42engineer42/Autonomous_drone_juuksur/Software/juuksur2.1/juuksur/README.md

# Juuksur

Robot, mis on mõeldud Robotex'il droonide takistus lennus võistlemiseks
