42engineer42/Autonomous_drone_juuksur/Electronics/REV3/Droon_REV3.xlsx

Sheet: Droon_REV3
Comment | Description | Designator | Footprint | LibRef | Quantity Required | Farnell product code | Quantity already available | Order Quantity
65R | Resistor | R1, R4, R8, R12, R15 | R 0603 | Res | 5 | 2331324 | 4 | 1 | -1
150R | Resistor | R17 | R 0603 | Res | 1 | 2447255 | 8 | 0 | 7 | -1
10R | Resistor | R2, R3, R5, R6, R10, R11, R13, R14 | R 0603 | Res | 8 | 2861437 | 0 | 10 | -8 | 2
1k | Resistor | R7 | R 0603 | Res | 1 | 1469740 | 0 | 10 | -1 | 9
2k | Resistor | R9 | R 0603 | Res | 1 | 1469764 | 0 | 10 | -1 | 9
13pF | Capacitor Ceramic | C5, C6 | C0603 | Capacitor | 2 | 1865473 | 18 | 0 | 16 | -2
0.1uF | Capacitor Ceramic | C1 | C0603 | Capacitor | 1 | 2429362 | 0 | 5 | -1 | 4
2.2uF | Capacitor Ceramic | C2 | C0603 | Capacitor | 1 | 3013394 | 0 | 5 | -1 | 4
10nF | Capacitor Ceramic | C3 | C0603 | Capacitor | 1 | 9406182 | 0 | 5 | -1 | 4
0.47uF | Capacitor Ceramic | C4 | C0603 | Capacitor | 1 | 1759405 | 0 | 5 | -1 | 4
10uF | Capacitor Ceramic | C8 | C0603 | Capacitor | 1 | 2494230 | 15 | 0 | 14
4.7uF | Capacitor Ceramic | C7 | C0603 | Capacitor | 1 | 3013398 | 16 | 0 | 15 | -1
OVS-3309 | LED RGB | D1, D2, D3, D4 | LED RGB | LED Tripple | 4 | 2917849 | 10 | 0 | 6 | -4
Header 6p | Header 6p | J2, J7, J8 | JST-SH 6pin 1mm pitch | Header 6p | 3 | 1679131 | 0 | 10 | -3 | 7
2x1 Header | 2x1 Header | J9, J10 | Header 1x2 2.54mm | 2x1 Header (power) | 2 | OK | OK | 0 | Piisavalt
150uH | Inductor | L2, L3 | Inductor 12.5x12.5x6mm | Inductor | 2 | 1852853 | 3 | 0 | 1
2V 20mA Green LED | LED | D5, D7 | LED 0603 | LED Single | 2 | 1465991 | 10 | 0 | 8
SS34 | Diode Schottky | D6 | Schottky Rectifier diode | Diode Schottky | 1 | 2101196 | 5 | 0 | 4
100uF | Capacitor | C9 | Capacitor Through Hole 5x11 | Capacitor Polarized | 1 | 2811468 | 0 | 3
470uF | Capacitor | C10 | Through hole Capacitor 16V 470uF | Capacitor Polarized | 1 | 9693602 | 0 | 3
16MHz | Quarz crystal | Q1 | Clock 2012"(5032) | Crystal | 1 | 1841946 | 5 | 0 | 4
Bluetooth HC-05 | Header 6p 2.54mm | J6 | HEADER 6x1 2.54 | Header 6p | 1 | OK | OK | 0 | Piisavalt
Inductor 1uH | Inductor | L1 | C1206 | Inductor | 1 | 2470288 | 6 | 0 | 5
LM2576-5.0WU | IC REG BUCK 5V 3A TO263-5 | U3 | 5V 3A REG | LM2576-5.0WU | 1 | 3008144 | 3 | 0 | 2
Power Switch 1A | Power Switch | J11 | POWER SWITCH | Power Switch | 1 | 2854845 | 3 | 0 | 2
Header 4p | Header 4p | J1, J3, J4 | JST-SH 4pin 1mm pitch | Header 4p | 3 | 1830839 | 4 | 0 | 1
RPi_PWR+UART | Header 2x20 2.54mm | J5 | Header 2x20 2.54mm | RPi_PWR+UART | 1 | 2847248 | 0 | 2 | 1
IMU | IMU | S1 | IMU-ICM-20689 | IMU_ICM-20689 | 1 | 2911512 | 0 | 2 | 1
STM32F303RDT6 | ARM Cortex-M4 32-bit MCU, 384 KB Flash, 80 KB Internal RAM, 51 I/Os, 64-Pin LQFP, -40 to 85 degC, Tray | U1 | LQFP64-STM32F303 | LQFP64-STM32F303 | 1 | 2488300 | 2 | 0 | 1
TSOT-5 3V3 REG | ANALOG DEVICES ADP2108AUJZ-3.3-R7 STEP-DOWN DC/DC CONVERTER, TSOT-5 | U2 | SOT-5 3V3 REG | TSOT-5 3V3 REG | 1 | 2112606 | 0 | 5
RPI3-MODAP - Single Board Computer, Raspberry Pi 3 Model A+, BCM2837B0 SoC, Dual-Band WiFi, IoT | Raspberry Pi 3 A+ | None | None | None | 1 | 2946269 | 0 | 2 | 1
HT-225D - Crimp Tool, Ratchet, 30-18AWG D-Sub Contacts | Crimp tool | None | None | None | 1 | 1624832 | 0 | 1 | 0
SSH-003T-P0.2 - Contact, SH Series, Socket, Crimp, 28 AWG, Tin Plated Contacts, JST SH Series Housings | JST-SH 1mm crimp | None | None | None | 20 | 1679142 | 0 | 100 | 80
SHR-06V-S-B - Connector Housing, SH Series, Receptacle, 6 Ways, 1 mm, SSH-003T-P0.2-H Contacts | JST-SH 1mm 6-pin | None | None | None | 3 | 1679112 | 0 | 100 | 97

Sheet: Order_BOM
Comment | Description | Designator | Footprint | LibRef | Quantity Required | Farnell product code | Quantity already available | Order Quantity
65R | Resistor | R1, R4, R8, R12, R15 | R 0603 | Res | 5 | 2331324 | 4 | 1
10R | Resistor | R2, R3, R5, R6, R10, R11, R13, R14 | R 0603 | Res | 8 | 2861437 | 0 | 10
1k | Resistor | R7 | R 0603 | Res | 1 | 1469740 | 0 | 10
2k | Resistor | R9 | R 0603 | Res | 1 | 1469764 | 0 | 10
0.1uF | Capacitor Ceramic | C1 | C0603 | Capacitor | 1 | 2429362 | 0 | 5
2.2uF | Capacitor Ceramic | C2 | C0603 | Capacitor | 1 | 3013394 | 0 | 5
10nF | Capacitor Ceramic | C3 | C0603 | Capacitor | 1 | 9406182 | 0 | 5
0.47uF | Capacitor Ceramic | C4 | C0603 | Capacitor | 1 | 1759405 | 0 | 5
Header 6p | Header 6p | J2, J7, J8 | JST-SH 6pin 1mm pitch | Header 6p | 3 | 1679131 | 0 | 10
100uF | Capacitor | C9 | Capacitor Through Hole 5x11 | Capacitor Polarized | 1 | 2811468 | 0 | 3
470uF | Capacitor | C10 | Through hole Capacitor 16V 470uF | Capacitor Polarized | 1 | 9693602 | 0 | 3
RPi_PWR+UART | Header 2x20 2.54mm | J5 | Header 2x20 2.54mm | RPi_PWR+UART | 1 | 2847248 | 0 | 2
IMU | IMU | S1 | IMU-ICM-20689 | IMU_ICM-20689 | 1 | 2911512 | 0 | 2
TSOT-5 3V3 REG | ANALOG DEVICES ADP2108AUJZ-3.3-R7 STEP-DOWN DC/DC CONVERTER, TSOT-5 | U2 | SOT-5 3V3 REG | TSOT-5 3V3 REG | 1 | 2112606 | 0 | 5
RPI3-MODAP - Single Board Computer, Raspberry Pi 3 Model A+, BCM2837B0 SoC, Dual-Band WiFi, IoT | Raspberry Pi 3 A+ | None | None | None | 1 | 2946269 | 0 | 2
HT-225D - Crimp Tool, Ratchet, 30-18AWG D-Sub Contacts | Crimp tool | None | None | None | 1 | 1624832 | 0 | 1
SSH-003T-P0.2 - Contact, SH Series, Socket, Crimp, 28 AWG, Tin Plated Contacts, JST SH Series Housings | JST-SH 1mm crimp | None | None | None | 20 | 1679142 | 0 | 100
SHR-06V-S-B - Connector Housing, SH Series, Receptacle, 6 Ways, 1 mm, SSH-003T-P0.2-H Contacts | JST-SH 1mm 6-pin | None | None | None | 3 | 1679112 | 0 | 100
