42engineer42/Autonomous_drone_juuksur/Mechanics/REV4/Lidari hoidik vl53l1x-ga.SLDASM

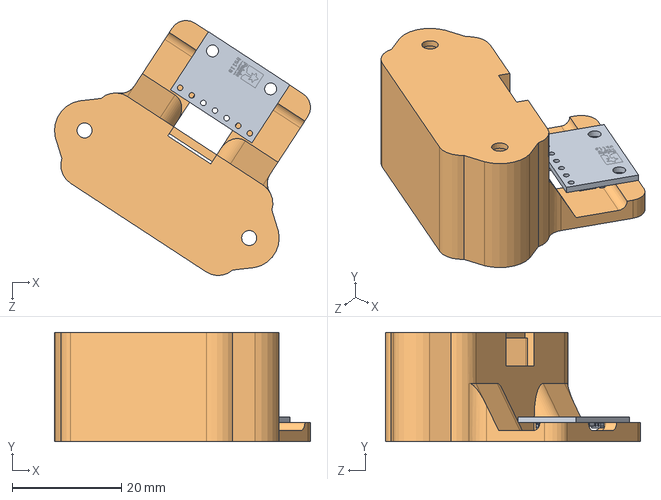
[picture p1: CAD file, 2022-08-14]
Mechanics/REV4/Lidari hoidik vl53l1x-ga.SLDASM
46.9 x 20.0 x 46.7 mm
vl53l1x moodul
vl53l1x hoidik koos lidariga oiget pidi
