42engineer42/Autonomous_drone_juuksur/Mechanics/REV4/Kaablite hoidiku test.SLDASM

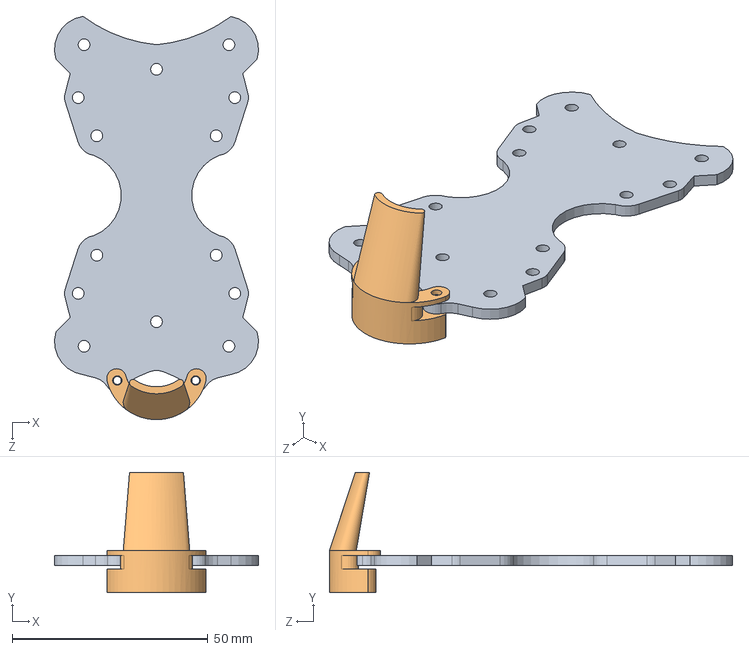
[picture p2: CAD file, 2022-08-14]
Mechanics/REV4/Kaablite hoidiku test.SLDASM
52.1 x 30.7 x 103.0 mm
vaheplaat2
Kaabite hoidik
