42engineer42/Autonomous_drone_juuksur/Mechanics/test/TATTU 1300mah 4s.SLDASM

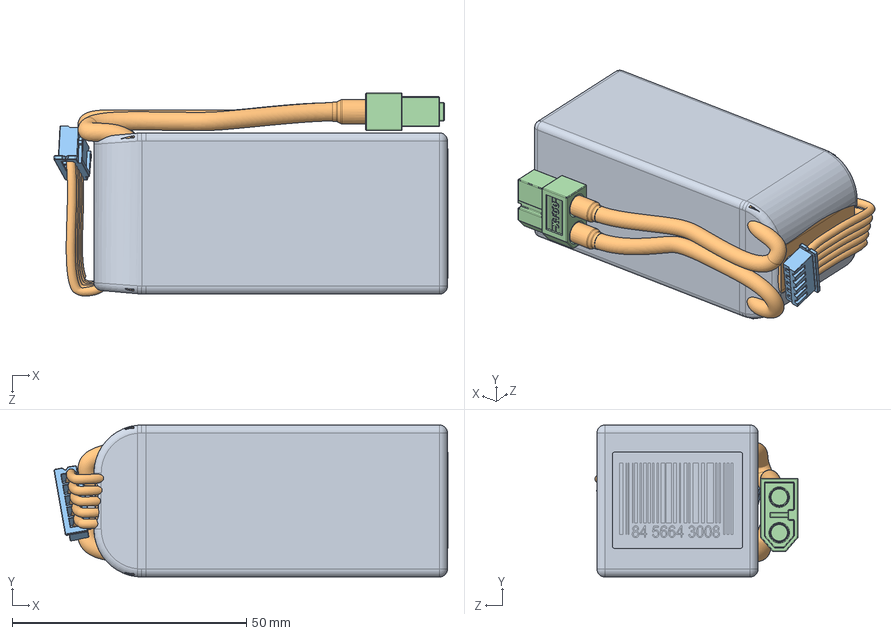
[picture p3: CAD file, 2022-08-14]
Mechanics/test/TATTU 1300mah 4s.SLDASM
84.0 x 32.4 x 43.3 mm
FUNDA 13
NUCLEO 13
JST XHP-4
XT60 Buchse
