42engineer42/Autonomous_drone_juuksur/Mechanics/test/Alumine elektroonika.SLDASM

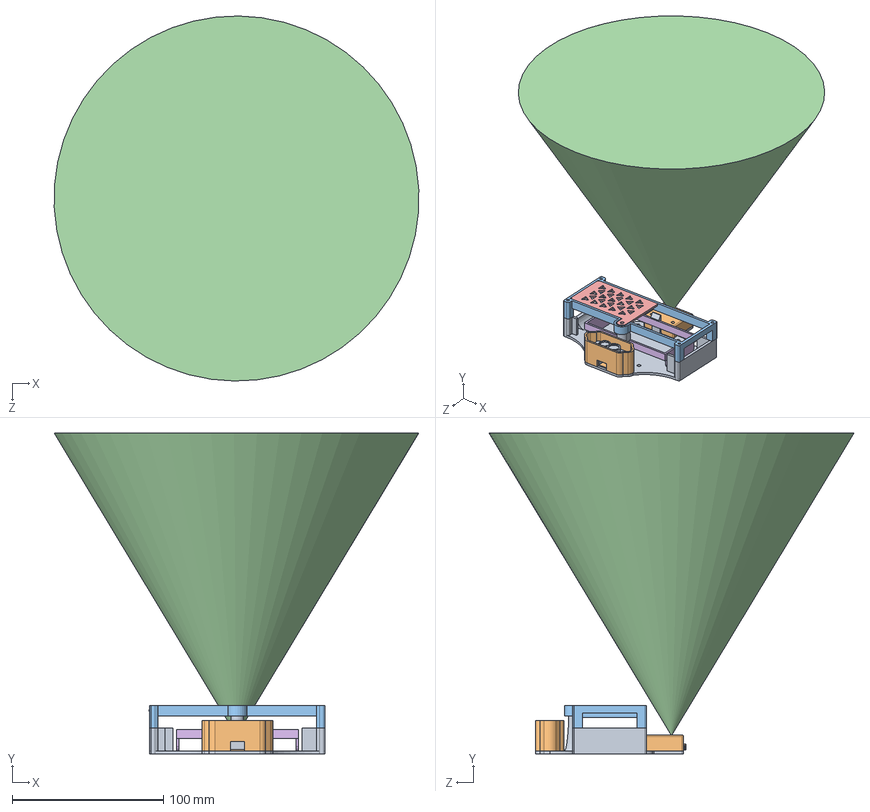
[picture p4: CAD file, 2022-08-14]
Mechanics/test/Alumine elektroonika.SLDASM
241.0 x 212.0 x 241.3 mm
Kaamera, aku ja lidari kinnitus
Lidari kaitse
70521906_01.stp
70521906_02.stp
70521906_03.stp
70521906_04.stp
70521906_05.stp
70521906_06.stp
70521906_07.stp
PicameraPCB.stp
OVA5647_Housing.stp
OVA5647_Lens_FOV.stp
ribbon_cam.stp
CCD.stp
CAPC-0805-T0.75-BN.stp x 2
CAPC-0402-T0.55-BN.stp x 10
RESC-0402.stp x 3
RESC-0603.stp x 2
RESC-1210.stp
c-1-1734248-5-e-raspberry_display.stp
SOT23-5.stp x 3
KX7 SMD Quartz Crystal Resonator 3.2x2.5mm.stp
c6aaa.stp
4pin_smd.stp x 3
TFmini lidar sensor CAD
Kaamera cover
Aku kinnitus 1
Aku kinnitusplaat
vana aku adapter
