42engineer42/Autonomous_drone_juuksur/Mechanics/test/jala assembly.SLDASM

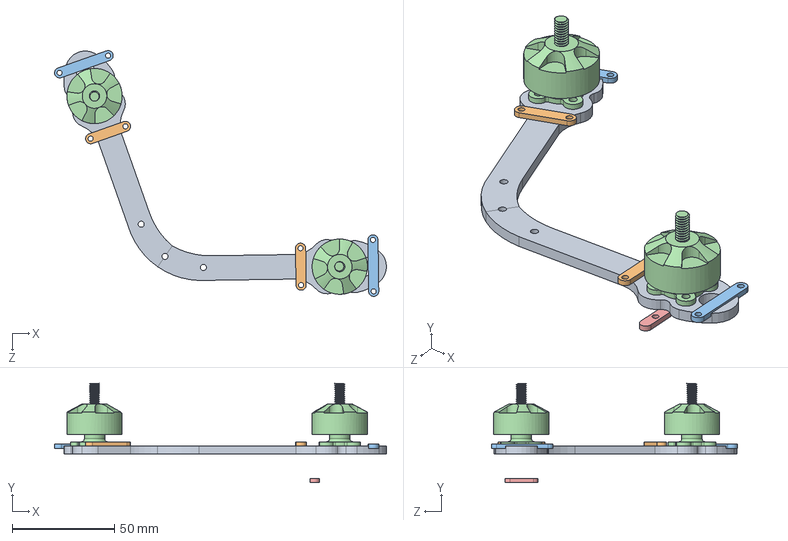
[picture p5: CAD file, 2022-08-14]
Mechanics/test/jala assembly.SLDASM
162.0 x 48.4 x 120.0 mm
Drone_arm x 2
jala_seib1 x 2
jala_seib2 x 2
mootor x 2
Flexi seib
