42engineer42/Autonomous_drone_juuksur/Mechanics/test/Reciever_assembly.SLDASM

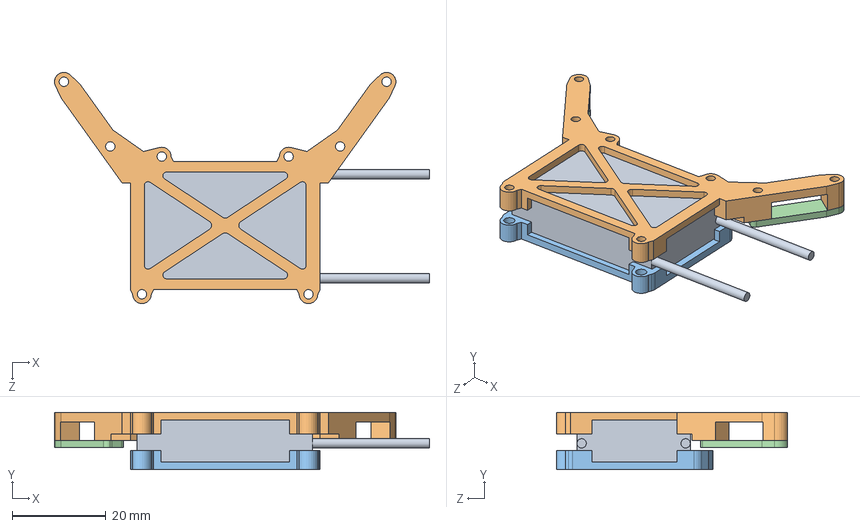
[picture p6: CAD file, 2022-08-14]
Mechanics/test/Reciever_assembly.SLDASM
80.1 x 12.2 x 49.4 mm
reciever
reciever_KinnitusAlumine
reciever_KinnitusYlemine
Reciever_seib x 2
