42engineer42/Autonomous_drone_juuksur/Electronics/REV3/PiHat_REV1 CAD/FC_PiHat_REV1.step

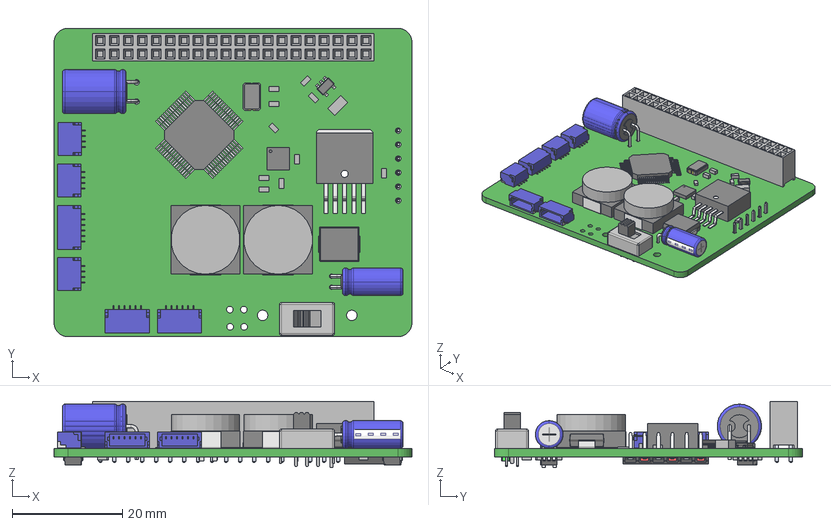
[picture p8: CAD file, 2022-08-14]
Electronics/REV3/PiHat_REV1 CAD/FC_PiHat_REV1.step
65.0 x 56.0 x 12.0 mm
BoardFC_PiHat_REV1
SM06B-SRSS-TB x 3
User_Library-Cap_electro_8x11_5x3_5mm_RA
User_Library-EG1940-ND
Pootje_RGB_LED x 24
ASMT-YTC2-0AA02 x 4
Open_CASCADE_STEP_translator_6.8_14.1
Open_CASCADE_STEP_translator_6.8_14.2.1
Thermal_Shape
Pin_Shape x 24
Extruded x 31
female_header_a-bl254-ea-g02d x 3
SM04B-SRSS-TB x 3
User_Library-Header_2x20_2_54mm
Open_CASCADE_STEP_translator_6.8_3.3.1 x 4
Open_CASCADE_STEP_translator_6.8_42.1
Open_CASCADE_STEP_translator_6.8_42.2.1
Lead x 7
Open_CASCADE_STEP_translator_6.8_42.8.1
Open_CASCADE_STEP_translator_6.8_45.1.1
Open_CASCADE_STEP_translator_6.8_3.1.1
Leader x 69
Open_CASCADE_STEP_translator_6.8_6.1.1
User_Library-445-CRYTAL-SMD
User_Library-Cap_electro_5x11x2mm_RA
