42engineer42/Autonomous_drone_juuksur/Mechanics/REV4/Lidari kaitse koos VL53L1X.SLDPRT

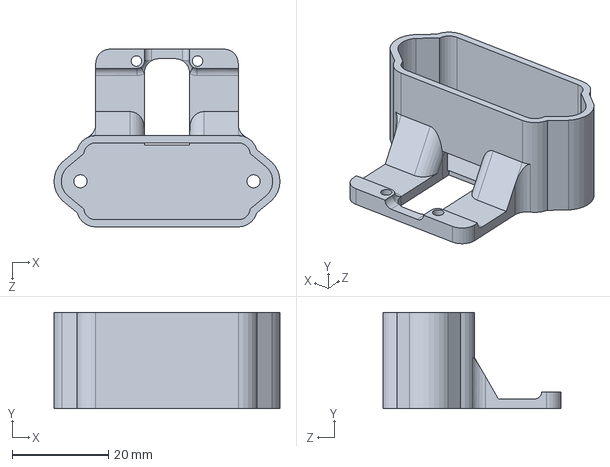
[picture p9: CAD file, 2022-08-14]
Mechanics/REV4/Lidari kaitse koos VL53L1X.SLDPRT
47.0 x 20.0 x 37.0 mm
