42engineer42/Autonomous_drone_juuksur/Mechanics/test/3D_print/aku_vahesein.2tk.STL

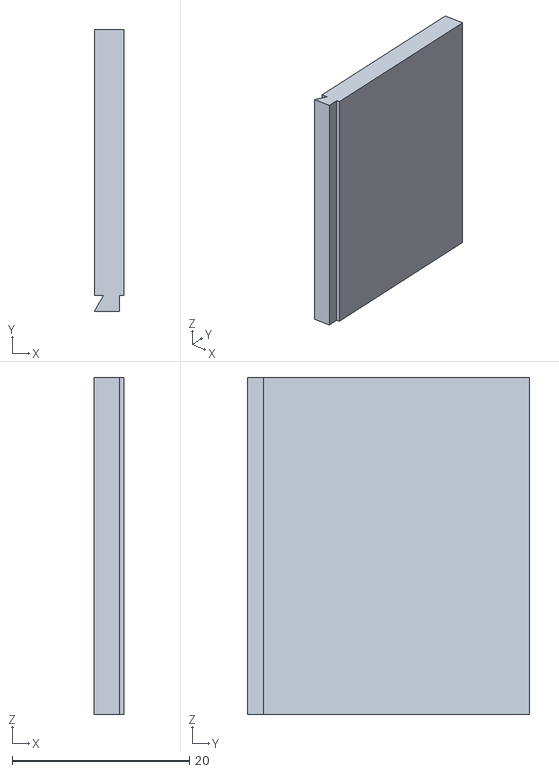
[picture p10: CAD file, 2022-09-05]
Mechanics/test/3D_print/aku_vahesein.2tk.STL
3.34 x 31.8 x 38.0
