42engineer42/Autonomous_drone_juuksur/Mechanics/test/aku_kaas.SLDPRT

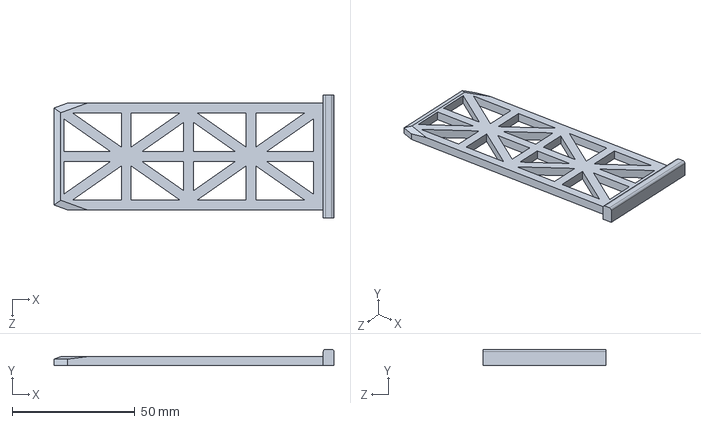
[picture p11: CAD file, 2022-09-05]
Mechanics/test/aku_kaas.SLDPRT
114.0 x 6.70 x 50.0 mm
