42engineer42/Autonomous_drone_juuksur/Mechanics/REV4/Kaabite hoidik.SLDPRT

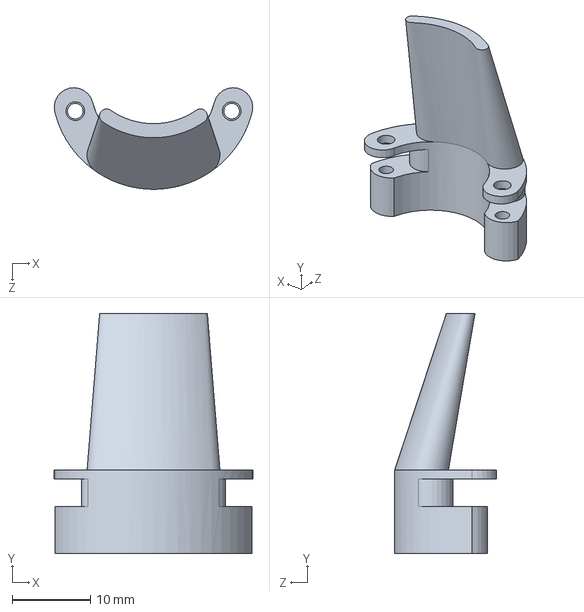
[picture p12: CAD file, 2022-08-14]
Mechanics/REV4/Kaabite hoidik.SLDPRT
25.4 x 30.7 x 13.0 mm
