42engineer42/Autonomous_drone_juuksur/Mechanics/test/3D_print/vahepuks.4tk.STL

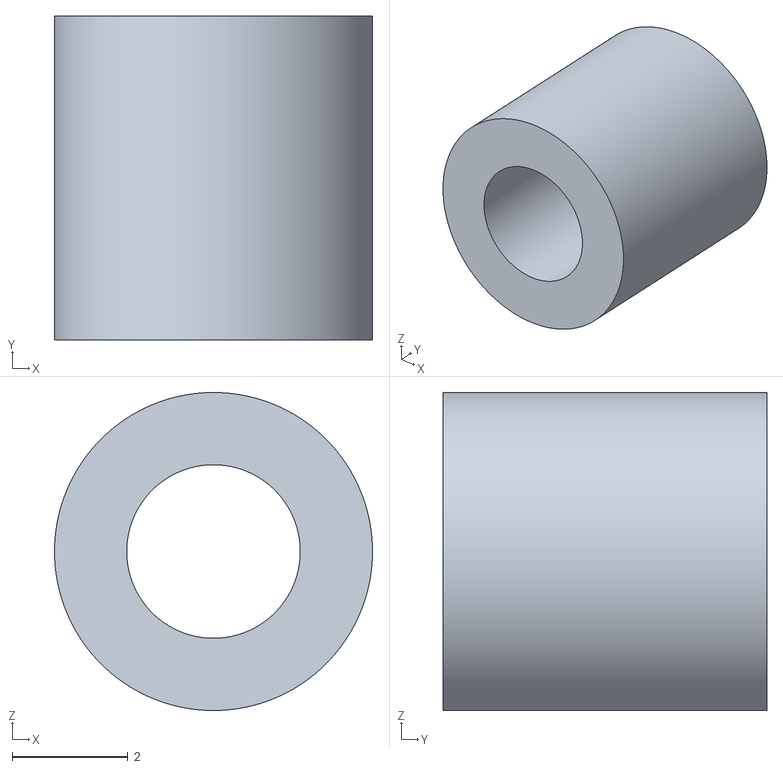
[picture p13: CAD file, 2022-09-05]
Mechanics/test/3D_print/vahepuks.4tk.STL
5.50 x 5.60 x 5.50
