42engineer42/Autonomous_drone_juuksur/Mechanics/test/receiver_kinnitus.SLDPRT

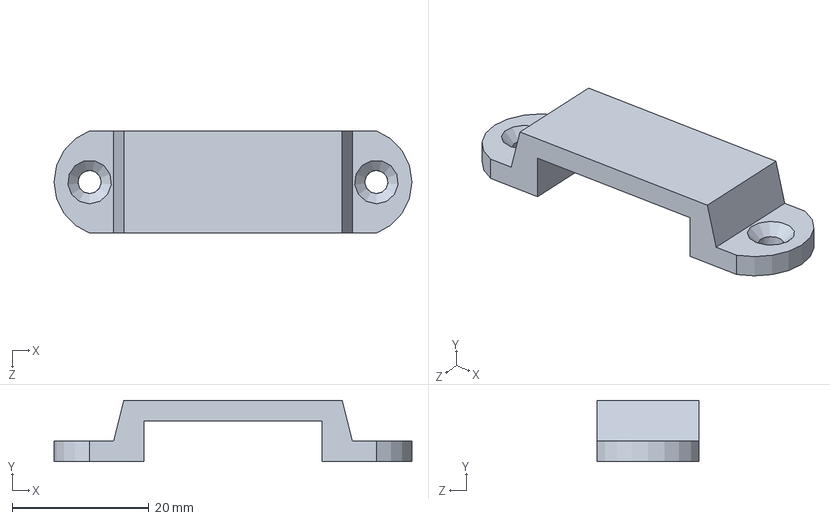
[picture p14: CAD file, 2022-09-05]
Mechanics/test/receiver_kinnitus.SLDPRT
52.4 x 9.00 x 15.0 mm
