42engineer42/Autonomous_drone_juuksur/Mechanics/test/juhtme_guide.SLDPRT

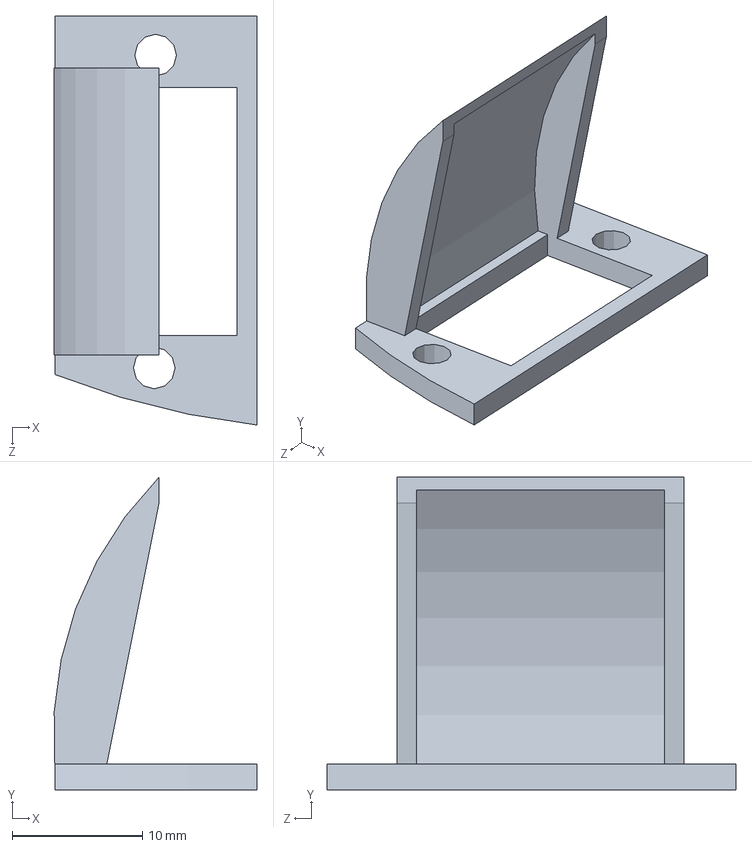
[picture p15: CAD file, 2022-09-05]
Mechanics/test/juhtme_guide.SLDPRT
15.5 x 24.0 x 31.4 mm
