42engineer42/Autonomous_drone_juuksur/Mechanics/REV4/Spacer.SLDPRT

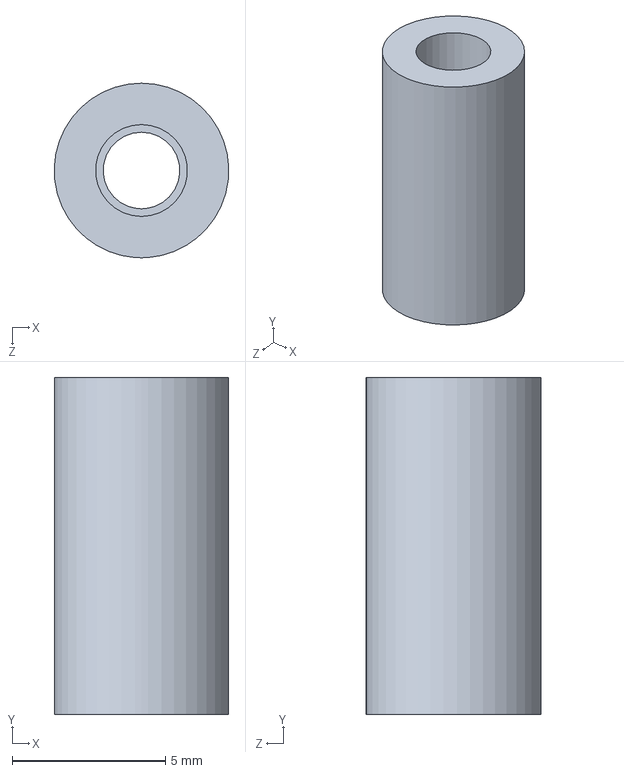
[picture p16: CAD file, 2022-08-14]
Mechanics/REV4/Spacer.SLDPRT
5.70 x 11.0 x 5.70 mm
