42engineer42/Autonomous_drone_juuksur/Mechanics/test/testimisaas.SLDPRT

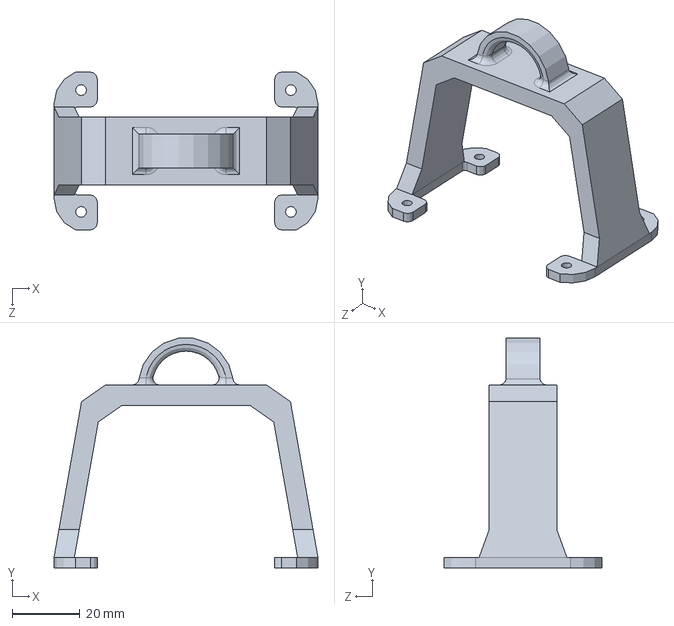
[picture p17: CAD file, 2022-09-05]
Mechanics/test/testimisaas.SLDPRT
78.0 x 67.8 x 46.6 mm
