42engineer42/Autonomous_drone_juuksur/Mechanics/REV4/vl53l1x hoidik.sldprt

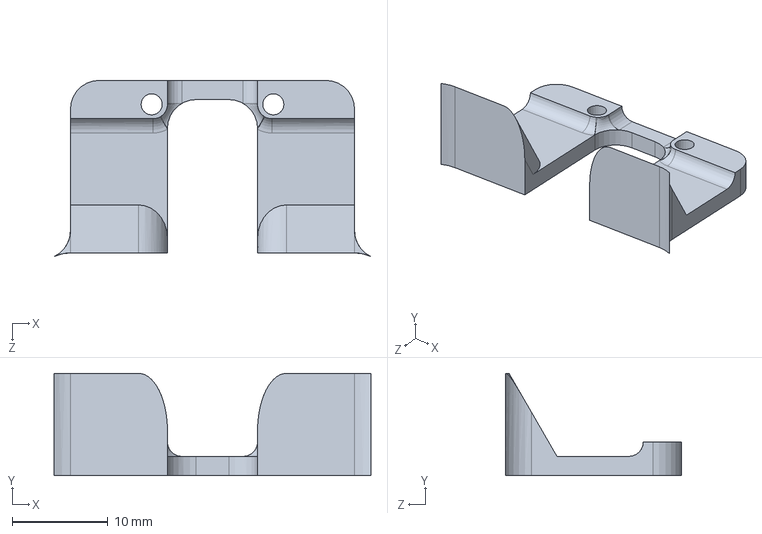
[picture p18: CAD file, 2022-08-14]
Mechanics/REV4/vl53l1x hoidik.sldprt
33.1 x 10.7 x 18.4 mm
