42engineer42/Autonomous_drone_juuksur/Mechanics/REV4/IMU 6050 kinnitus.SLDPRT

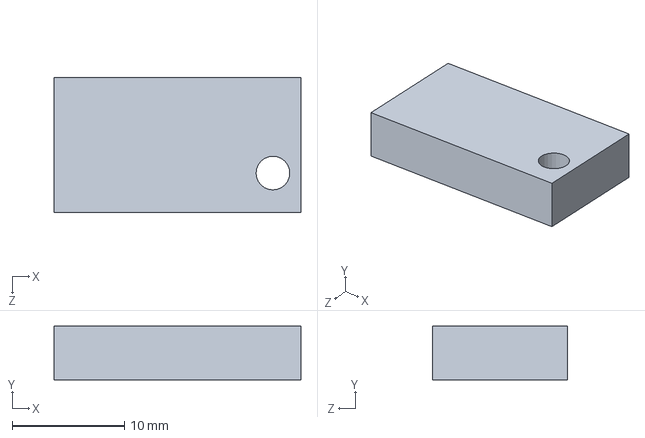
[picture p19: CAD file, 2022-08-14]
Mechanics/REV4/IMU 6050 kinnitus.SLDPRT
22.0 x 4.80 x 12.0 mm
