42engineer42/Autonomous_drone_juuksur/Mechanics/test/akuplaat.v2.SLDPRT

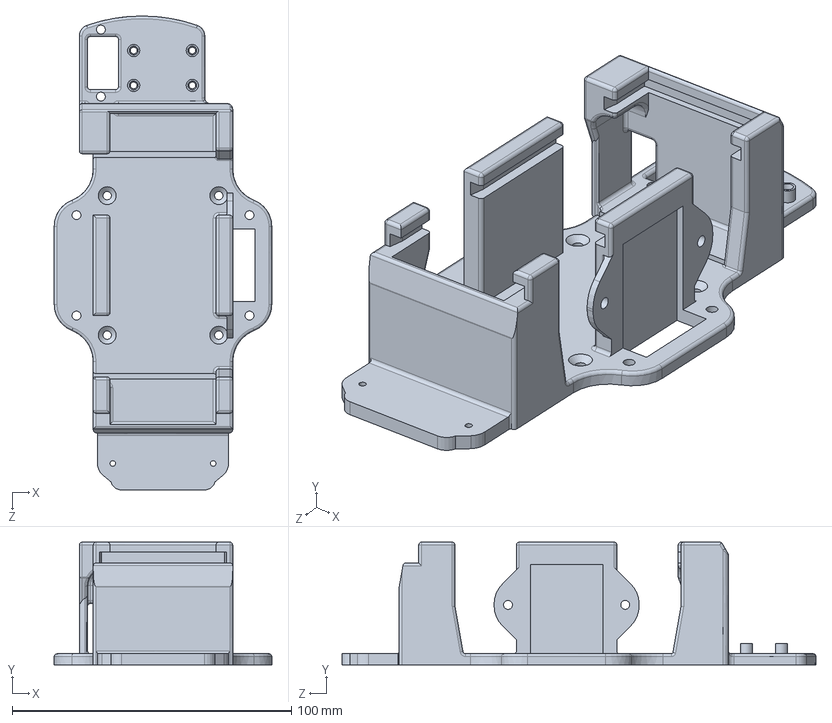
[picture p20: CAD file, 2022-09-05]
Mechanics/test/akuplaat.v2.SLDPRT
78.0 x 44.0 x 169.9 mm
