42engineer42/Autonomous_drone_juuksur/Mechanics/test/XT60 Buchse.SLDPRT

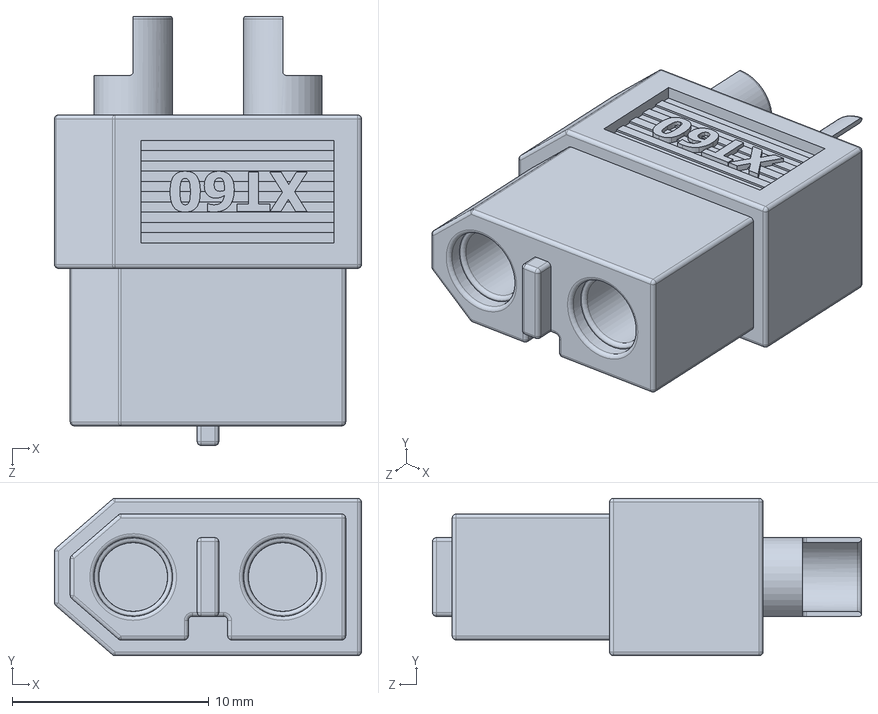
[picture p21: CAD file, 2022-08-14]
Mechanics/test/XT60 Buchse.SLDPRT
15.6 x 8.00 x 21.8 mm
