42engineer42/Autonomous_drone_juuksur/Mechanics/REV4/Lintkaabli hoidik.SLDPRT

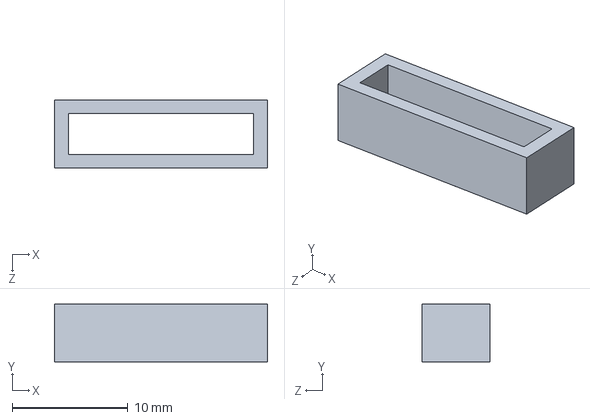
[picture p22: CAD file, 2022-08-14]
Mechanics/REV4/Lintkaabli hoidik.SLDPRT
18.4 x 5.00 x 5.90 mm
