42engineer42/Autonomous_drone_juuksur/Mechanics/test/Aku kinnitusplaat.SLDPRT

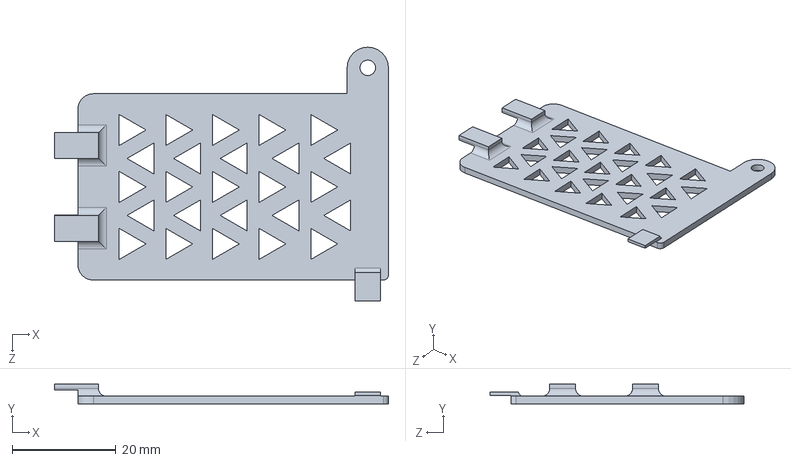
[picture p23: CAD file, 2022-08-14]
Mechanics/test/Aku kinnitusplaat.SLDPRT
64.5 x 3.85 x 49.0 mm
