42engineer42/Autonomous_drone_juuksur/Mechanics/REV4/vl53l1x moodul.SLDPRT

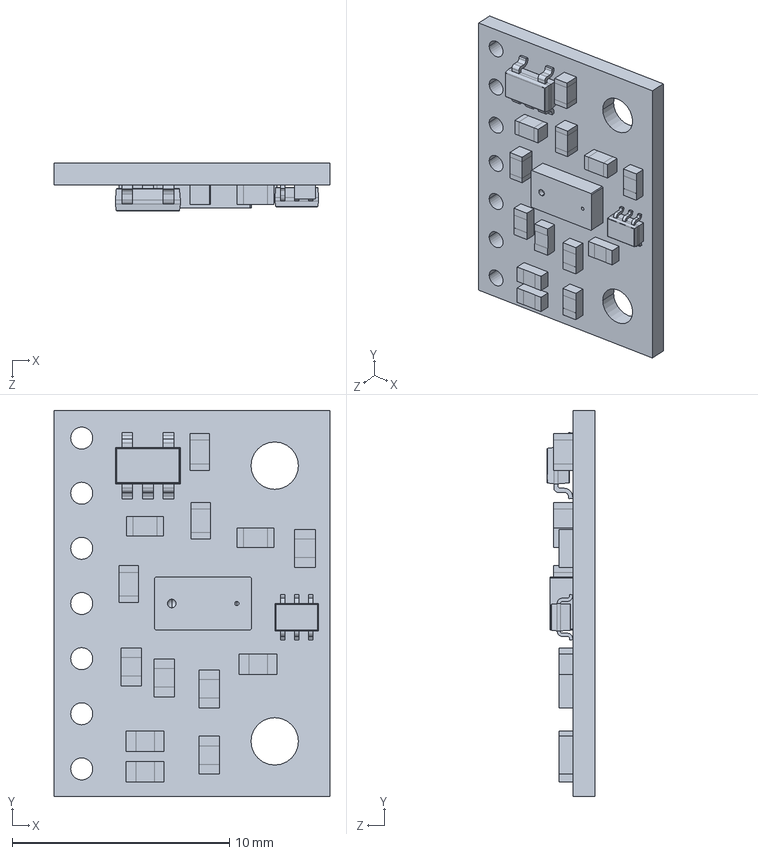
[picture p24: CAD file, 2022-08-14]
Mechanics/REV4/vl53l1x moodul.SLDPRT
12.7 x 17.8 x 2.21 mm
