42engineer42/Autonomous_drone_juuksur/Mechanics/test/jala_seib1.SLDPRT

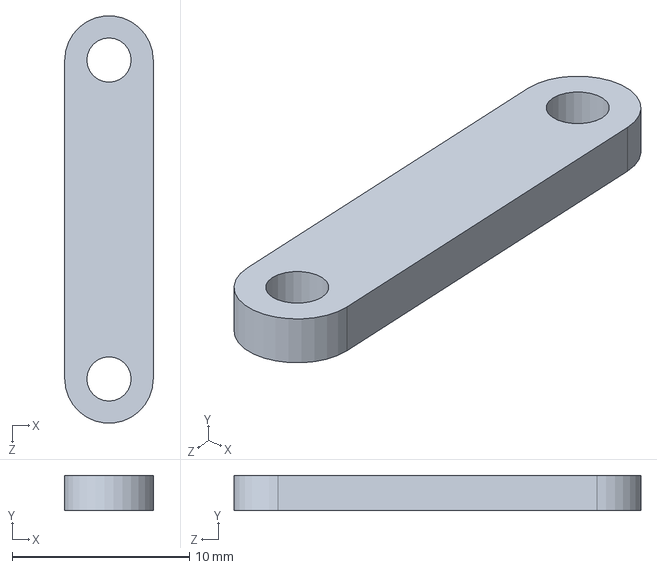
[picture p25: CAD file, 2022-08-14]
Mechanics/test/jala_seib1.SLDPRT
5.00 x 2.00 x 23.0 mm
