42engineer42/Autonomous_drone_juuksur/Mechanics/REV4/vl53l1x hoidik koos lidariga oiget pidi.SLDPRT

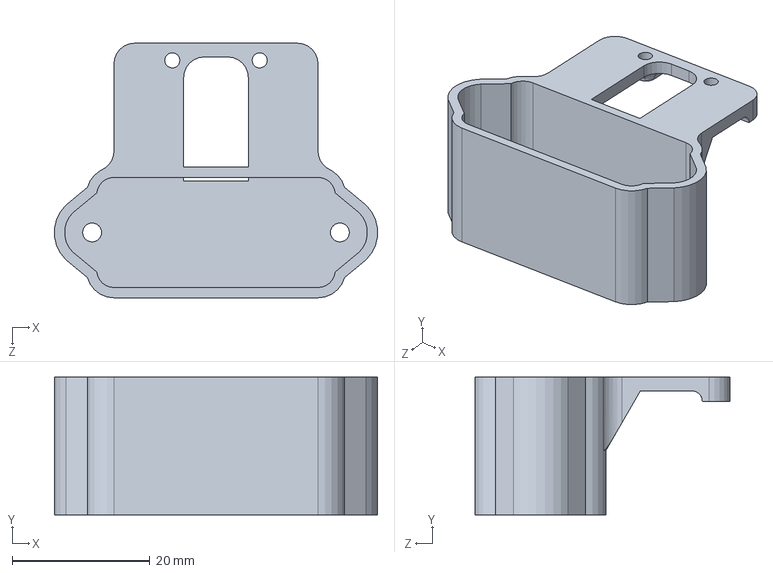
[picture p26: CAD file, 2022-08-14]
Mechanics/REV4/vl53l1x hoidik koos lidariga oiget pidi.SLDPRT
46.9 x 20.0 x 37.0 mm
