42engineer42/Autonomous_drone_juuksur/Mechanics/test/Kaamera, aku ja lidari kinnitus.SLDPRT

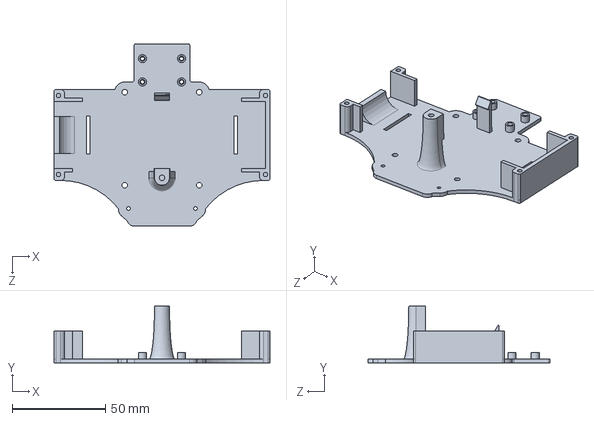
[picture p27: CAD file, 2022-08-14]
Mechanics/test/Kaamera, aku ja lidari kinnitus.SLDPRT
116.0 x 30.5 x 98.0 mm
