42engineer42/Autonomous_drone_juuksur/Mechanics/test/vaheplaat2.SLDPRT

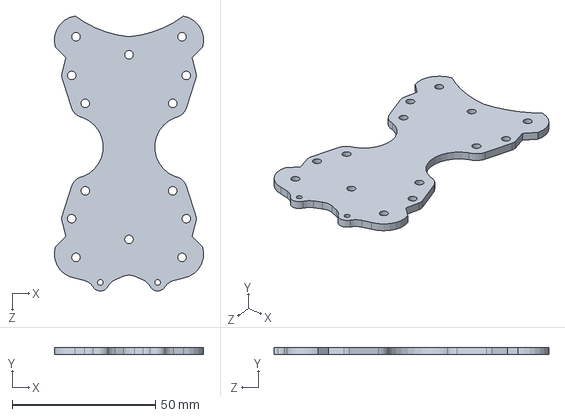
[picture p28: CAD file, 2022-08-14]
Mechanics/test/vaheplaat2.SLDPRT
52.1 x 2.60 x 96.0 mm
