42engineer42/Autonomous_drone_juuksur/Mechanics/test/Puks_vaike.SLDPRT

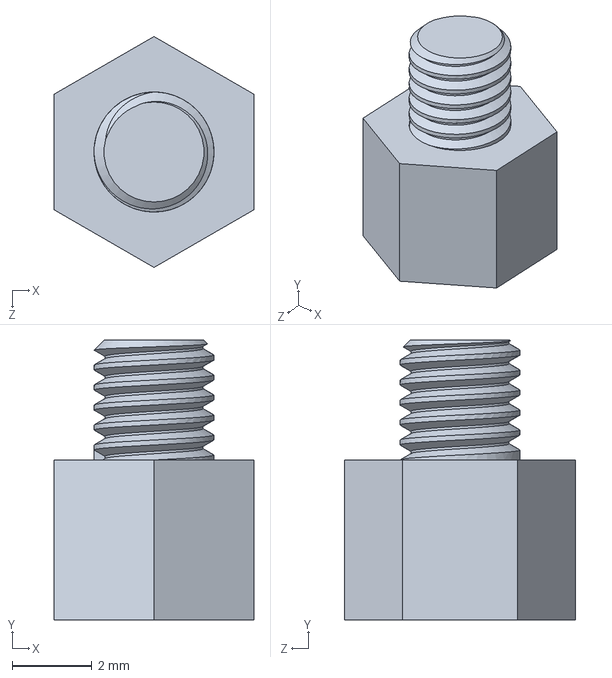
[picture p29: CAD file, 2022-08-14]
Mechanics/test/Puks_vaike.SLDPRT
5.00 x 7.00 x 5.77 mm
