42engineer42/Autonomous_drone_juuksur/Mechanics/test/flight controller.SLDPRT

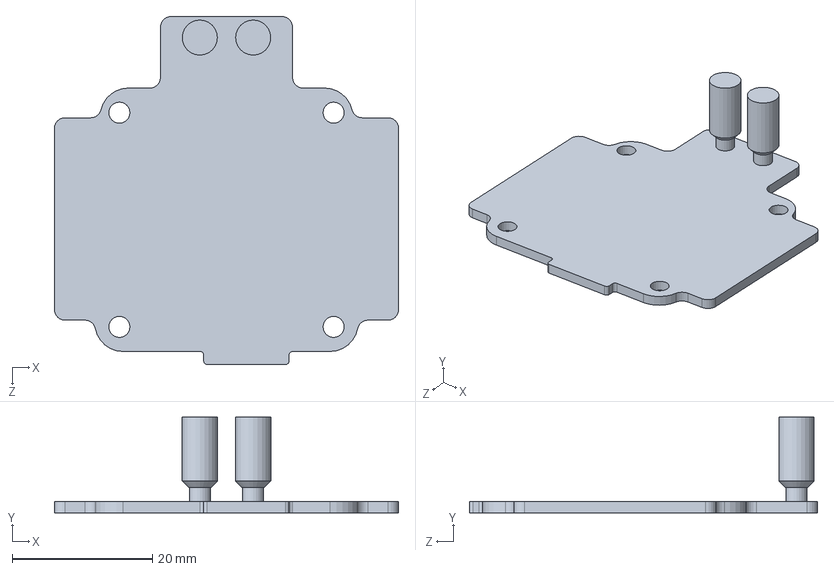
[picture p30: CAD file, 2022-08-14]
Mechanics/test/flight controller.SLDPRT
49.0 x 13.6 x 49.5 mm
