42engineer42/Autonomous_drone_juuksur/Mechanics/test/mootor.SLDPRT

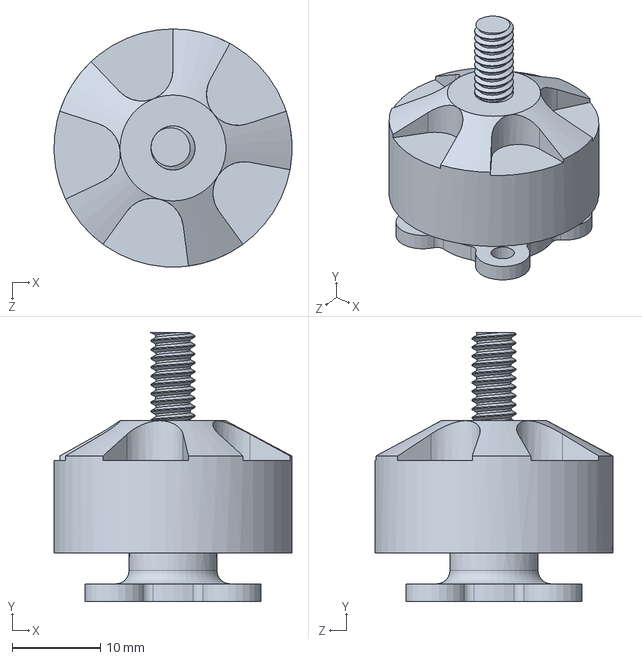
[picture p31: CAD file, 2022-08-14]
Mechanics/test/mootor.SLDPRT
27.0 x 30.5 x 27.0 mm
