42engineer42/Autonomous_drone_juuksur/Mechanics/test/Aku kinnitus 1.SLDPRT

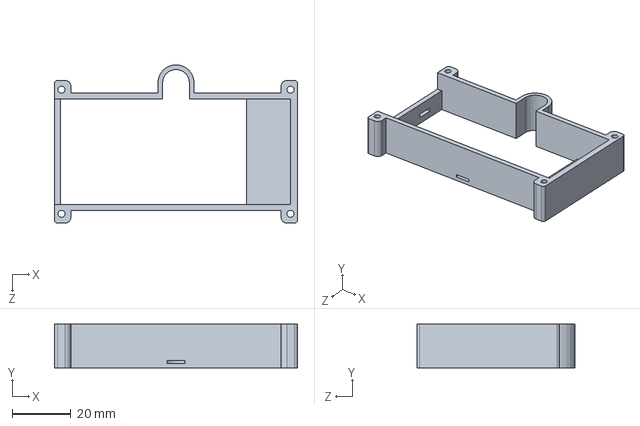
[picture p32: CAD file, 2022-08-14]
Mechanics/test/Aku kinnitus 1.SLDPRT
83.0 x 15.0 x 54.1 mm
