42engineer42/Autonomous_drone_juuksur/Mechanics/test/reciever_KinnitusAlumine.SLDPRT

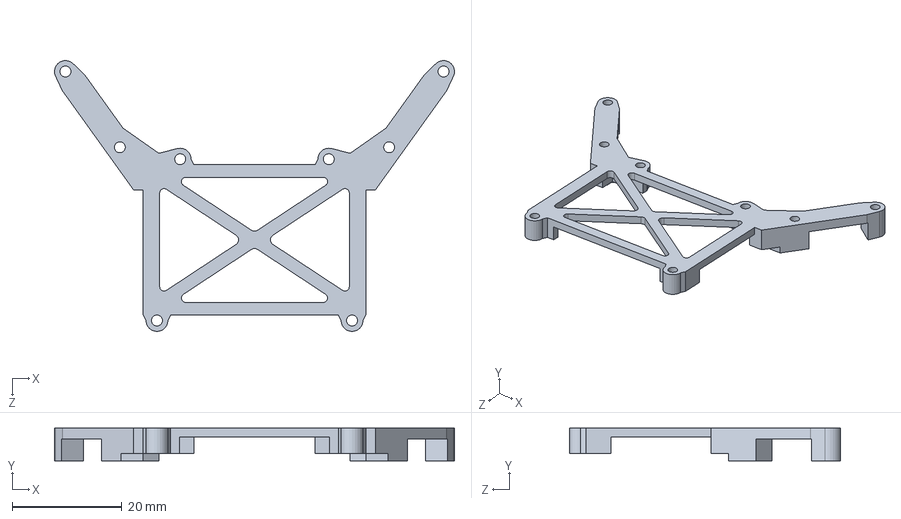
[picture p33: CAD file, 2022-08-14]
Mechanics/test/reciever_KinnitusAlumine.SLDPRT
72.9 x 6.00 x 49.4 mm
