42engineer42/Autonomous_drone_juuksur/Mechanics/test/Pisem kaamera nurk.SLDPRT

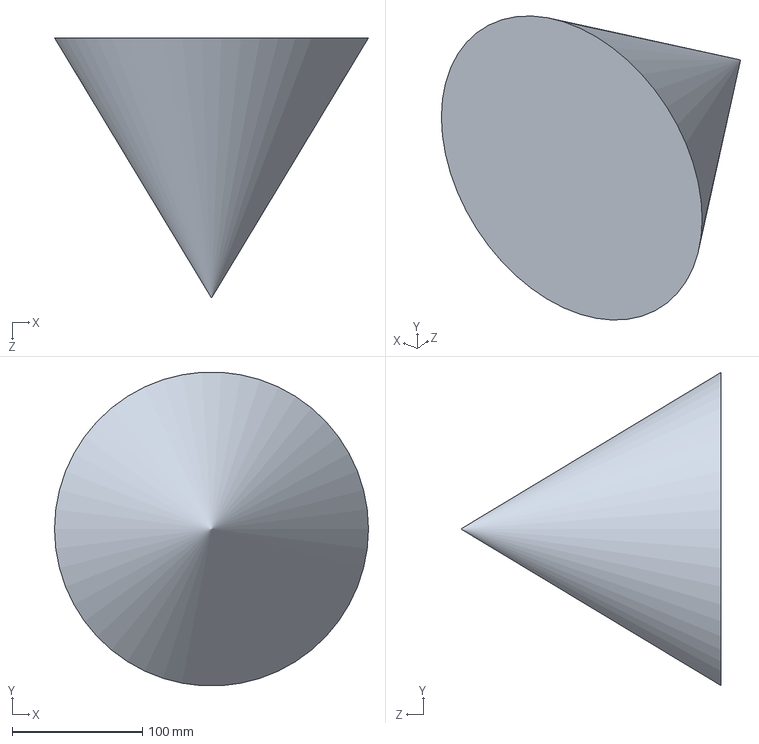
[picture p34: CAD file, 2022-08-14]
Mechanics/test/Pisem kaamera nurk.SLDPRT
241.3 x 240.8 x 200.0 mm
