42engineer42/Autonomous_drone_juuksur/Mechanics/test/Raspberry kinnitus v1.1.SLDPRT

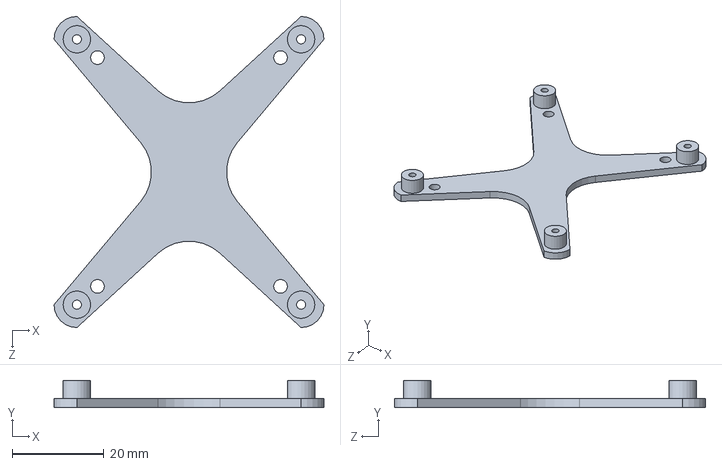
[picture p35: CAD file, 2022-08-14]
Mechanics/test/Raspberry kinnitus v1.1.SLDPRT
59.0 x 6.00 x 68.0 mm
