42engineer42/Autonomous_drone_juuksur/Mechanics/test/Kaamera cover.SLDPRT

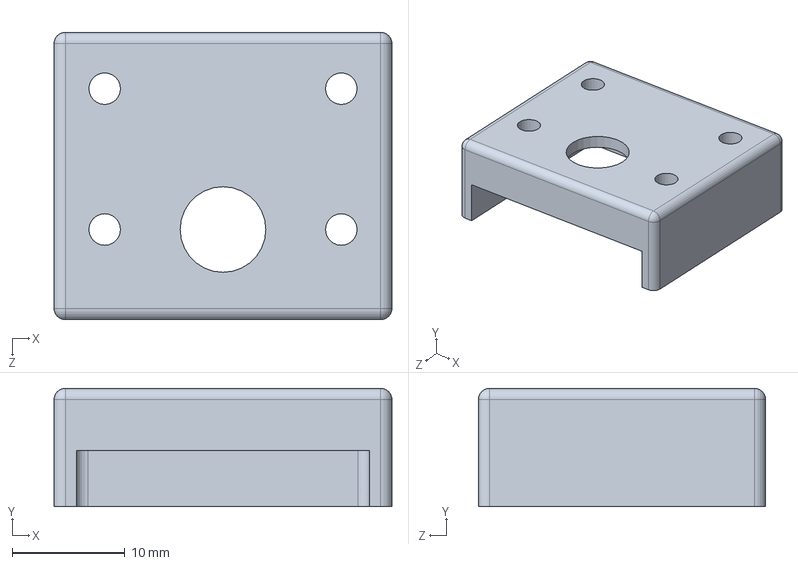
[picture p36: CAD file, 2022-08-14]
Mechanics/test/Kaamera cover.SLDPRT
30.0 x 10.5 x 25.5 mm
