42engineer42/Autonomous_drone_juuksur/Mechanics/test/Puks_suur.SLDPRT

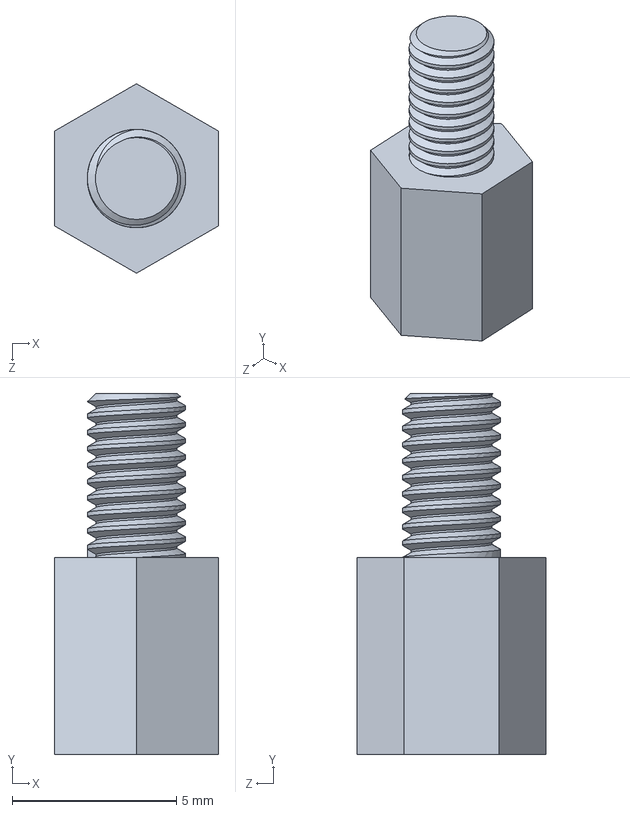
[picture p37: CAD file, 2022-08-14]
Mechanics/test/Puks_suur.SLDPRT
5.00 x 11.0 x 5.77 mm
