42engineer42/Autonomous_drone_juuksur/Mechanics/test/Propeller CW.SLDPRT

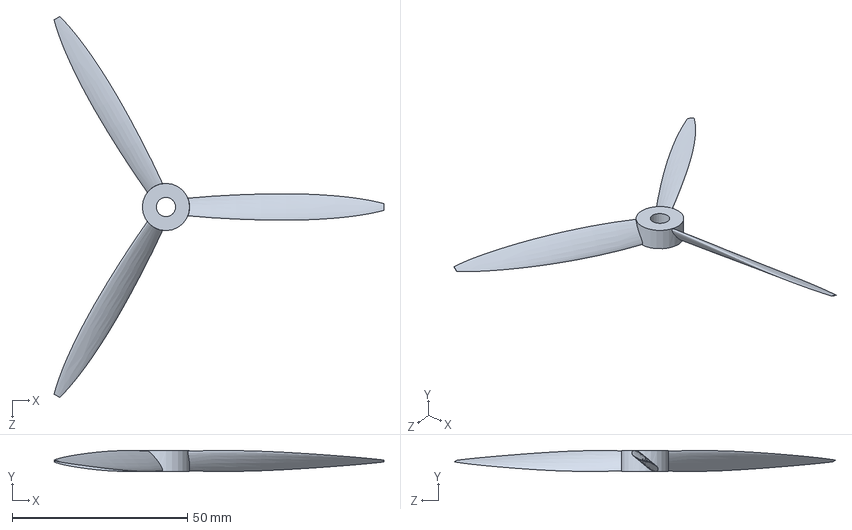
[picture p38: CAD file, 2022-08-14]
Mechanics/test/Propeller CW.SLDPRT
94.2 x 6.00 x 108.8 mm
