42engineer42/Autonomous_drone_juuksur/Mechanics/test/NUCLEO 13.SLDPRT

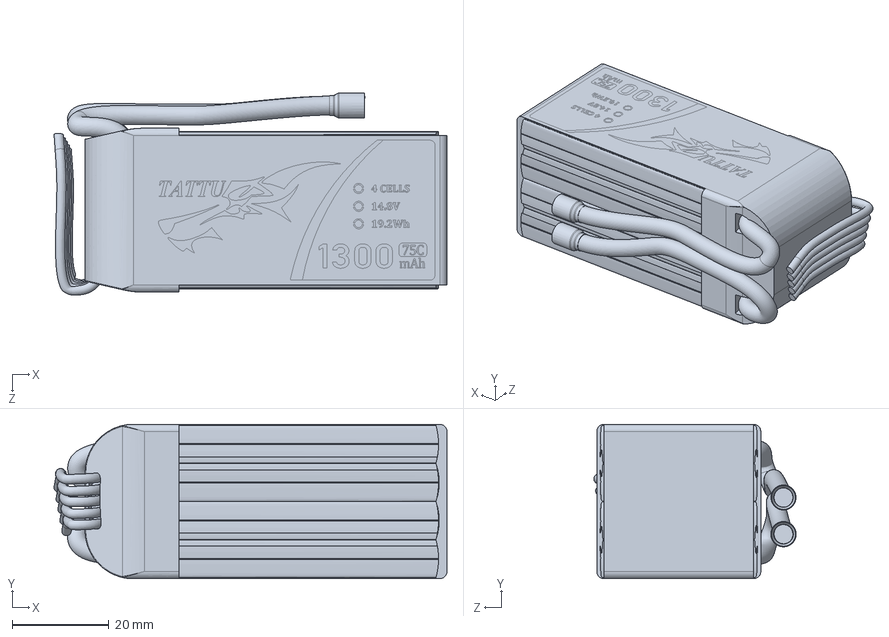
[picture p39: CAD file, 2022-08-14]
Mechanics/test/NUCLEO 13.SLDPRT
81.4 x 32.0 x 41.9 mm
