42engineer42/Autonomous_drone_juuksur/Mechanics/test/Mutter.SLDPRT

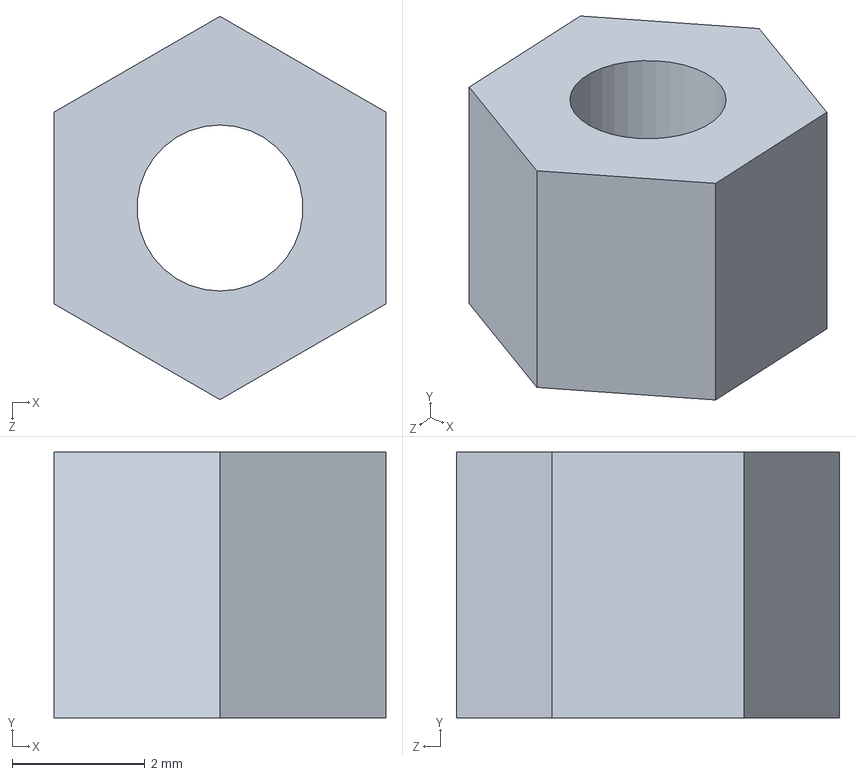
[picture p40: CAD file, 2022-08-14]
Mechanics/test/Mutter.SLDPRT
5.00 x 4.00 x 5.77 mm
