42engineer42/Autonomous_drone_juuksur/Mechanics/test/Droon_custom_PCB.SLDPRT

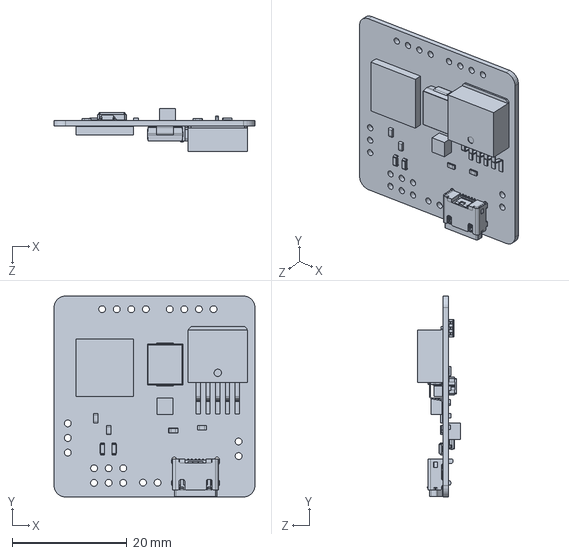
[picture p41: CAD file, 2022-08-14]
Mechanics/test/Droon_custom_PCB.SLDPRT
35.0 x 35.0 x 7.56 mm
