42engineer42/Autonomous_drone_juuksur/Mechanics/test/Drone_arm.SLDPRT

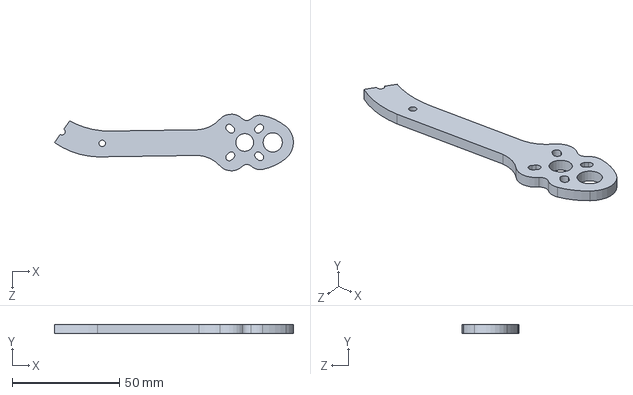
[picture p42: CAD file, 2022-08-14]
Mechanics/test/Drone_arm.SLDPRT
111.7 x 4.00 x 26.4 mm
