42engineer42/Autonomous_drone_juuksur/Mechanics/test/Post.SLDPRT

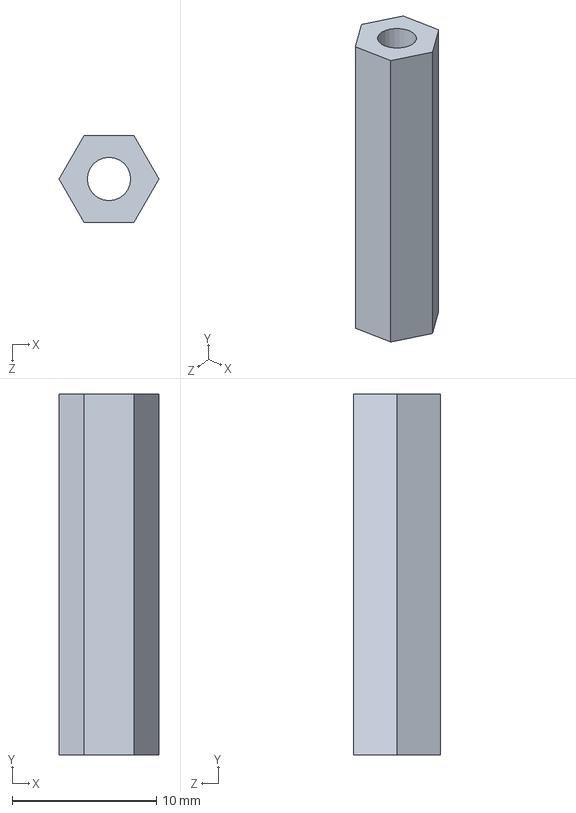
[picture p43: CAD file, 2022-08-14]
Mechanics/test/Post.SLDPRT
6.93 x 25.0 x 6.00 mm
