42engineer42/Autonomous_drone_juuksur/Mechanics/test/FC.SLDPRT

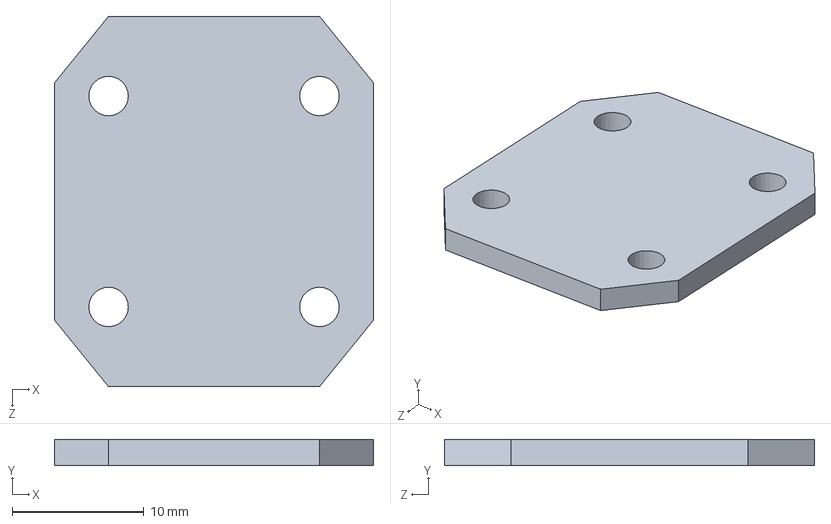
[picture p44: CAD file, 2022-08-14]
Mechanics/test/FC.SLDPRT
24.2 x 2.00 x 28.1 mm
