42engineer42/Autonomous_drone_juuksur/Mechanics/test/TFmini lidar sensor CAD.SLDPRT

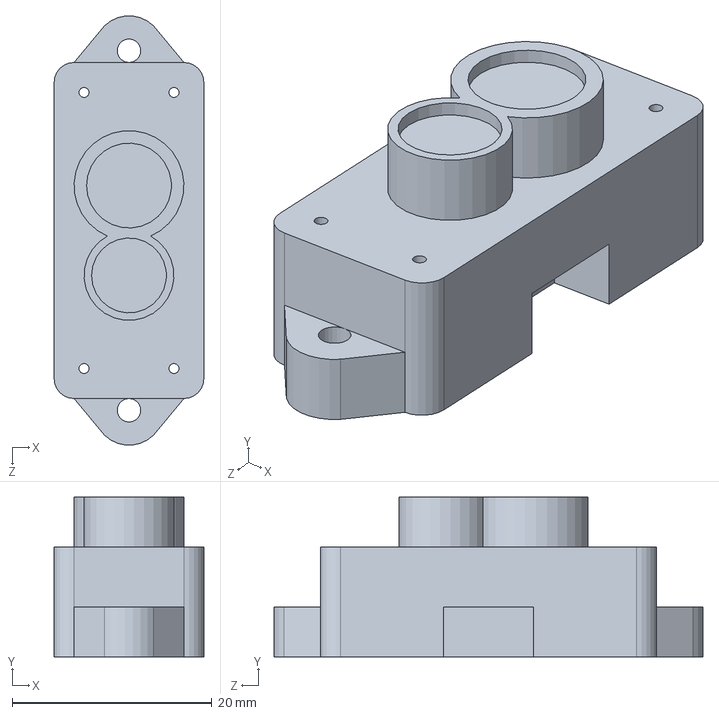
[picture p45: CAD file, 2022-08-14]
Mechanics/test/TFmini lidar sensor CAD.SLDPRT
15.0 x 16.0 x 43.0 mm
