42engineer42/Autonomous_drone_juuksur/Mechanics/test/Propeller CCW.SLDPRT

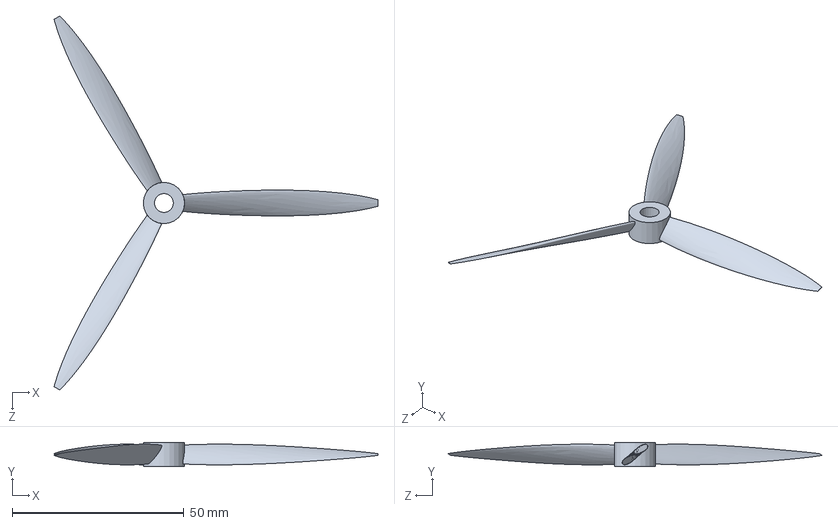
[picture p46: CAD file, 2022-08-14]
Mechanics/test/Propeller CCW.SLDPRT
94.2 x 7.00 x 108.8 mm
