42engineer42/Autonomous_drone_juuksur/Mechanics/test/reciever.SLDPRT

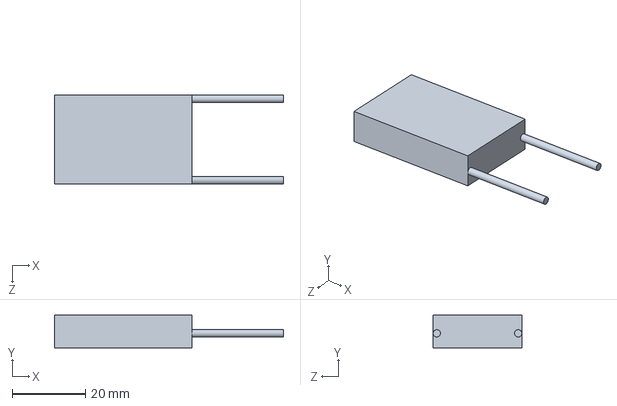
[picture p47: CAD file, 2022-08-14]
Mechanics/test/reciever.SLDPRT
62.5 x 9.00 x 24.2 mm
