42engineer42/Autonomous_drone_juuksur/Mechanics/test/JST XHP-4.SLDPRT

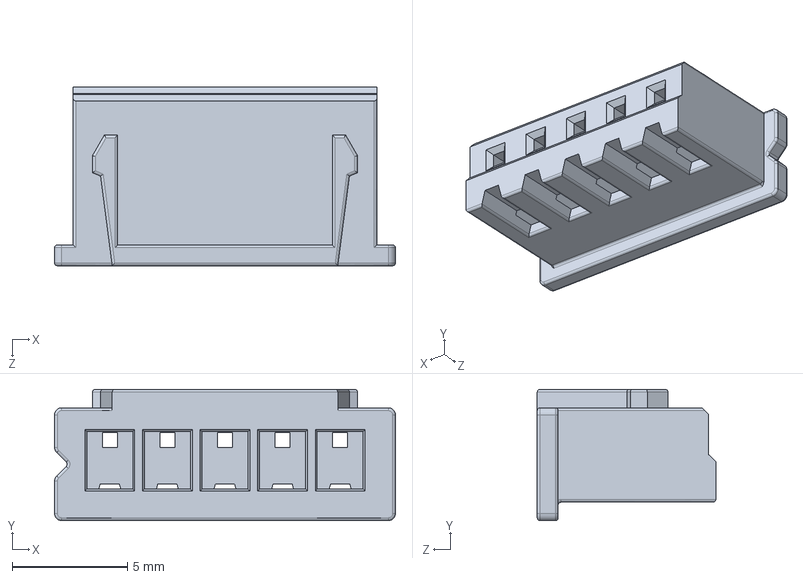
[picture p48: CAD file, 2022-08-14]
Mechanics/test/JST XHP-4.SLDPRT
14.8 x 5.70 x 7.75 mm
