42engineer42/Autonomous_drone_juuksur/Mechanics/test/Drooni jalg V7.SLDPRT

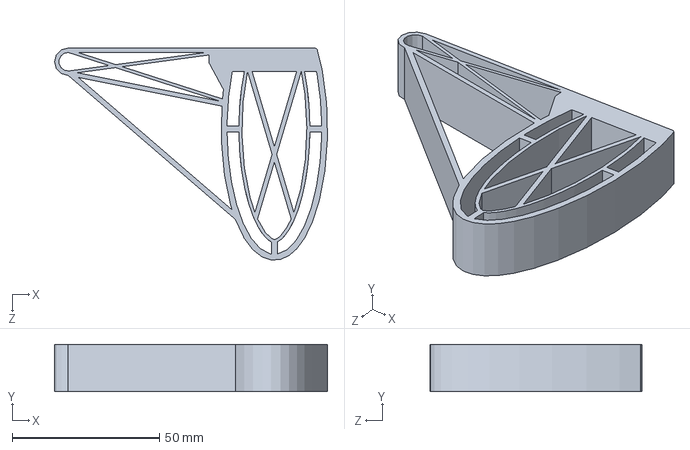
[picture p49: CAD file, 2022-08-14]
Mechanics/test/Drooni jalg V7.SLDPRT
92.6 x 16.0 x 71.9 mm
