42engineer42/Autonomous_drone_juuksur/Mechanics/test/Jala kinnitus V3.SLDPRT

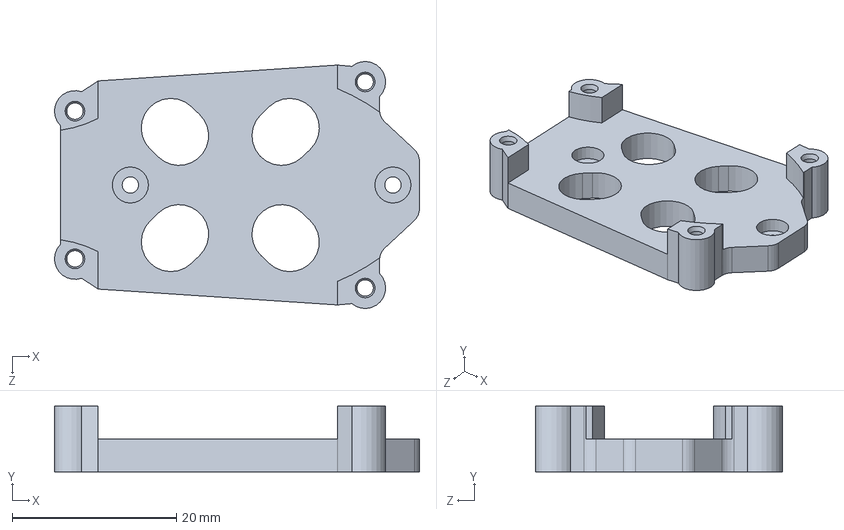
[picture p50: CAD file, 2022-08-14]
Mechanics/test/Jala kinnitus V3.SLDPRT
44.5 x 8.00 x 30.1 mm
