42engineer42/Autonomous_drone_juuksur/Mechanics/test/Lidari kaitse.SLDPRT

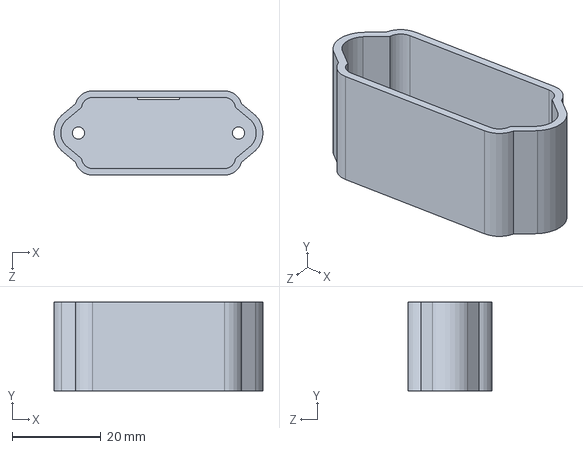
[picture p51: CAD file, 2022-08-14]
Mechanics/test/Lidari kaitse.SLDPRT
47.0 x 20.0 x 19.0 mm
