42engineer42/Autonomous_drone_juuksur/Mechanics/test/vana aku adapter.SLDPRT

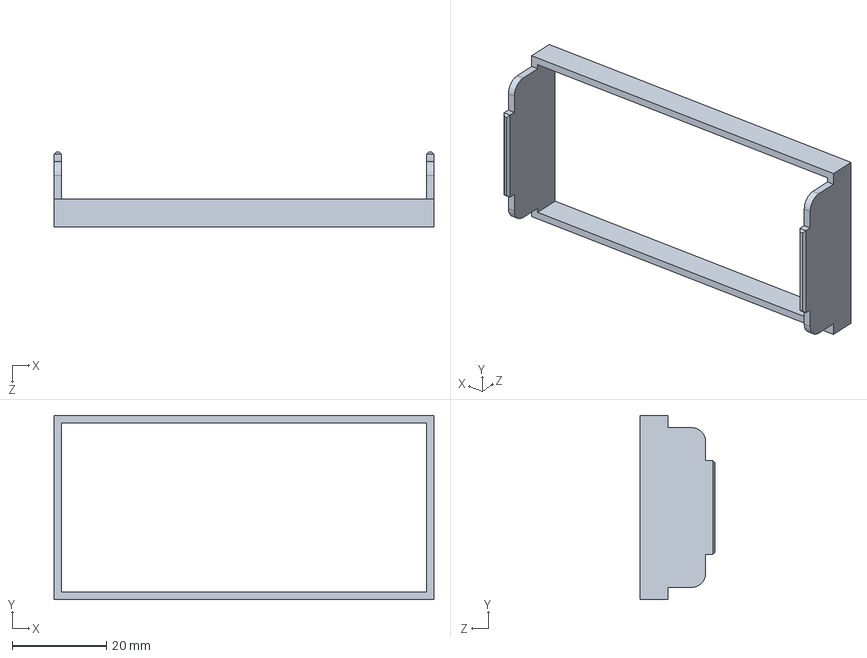
[picture p52: CAD file, 2022-08-14]
Mechanics/test/vana aku adapter.SLDPRT
80.8 x 39.2 x 16.0 mm
