42engineer42/Autonomous_drone_juuksur/Mechanics/test/Flexi seib.SLDPRT

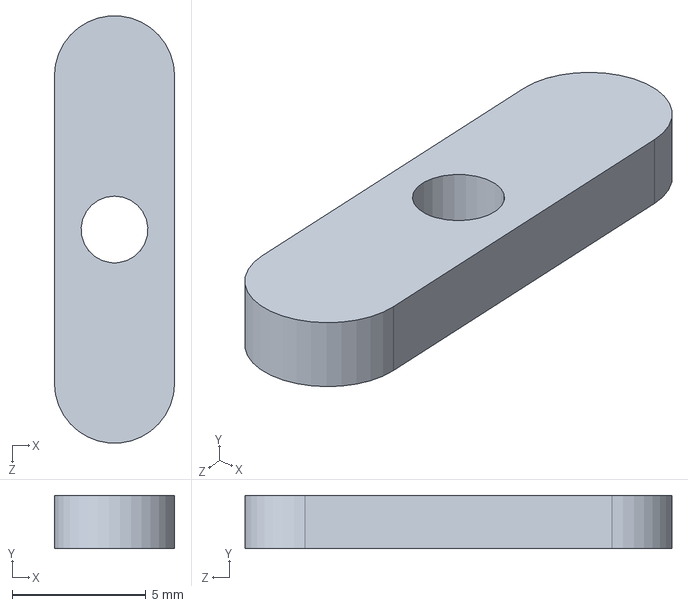
[picture p53: CAD file, 2022-08-14]
Mechanics/test/Flexi seib.SLDPRT
4.50 x 2.00 x 16.0 mm
