42engineer42/Autonomous_drone_juuksur/Mechanics/test/Reciever_seib.SLDPRT

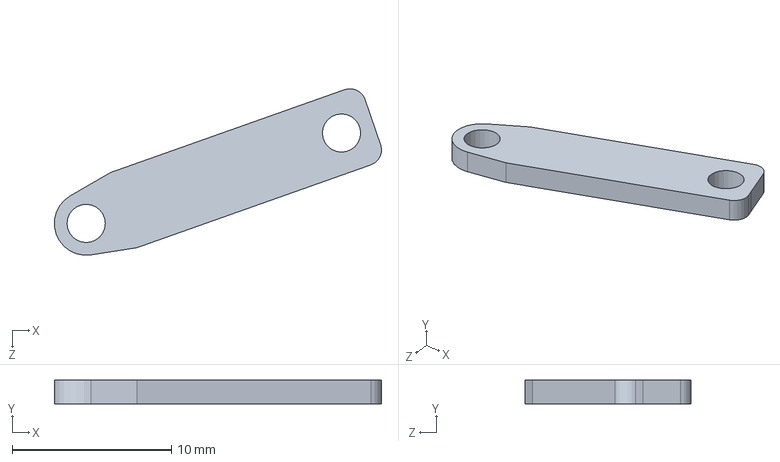
[picture p54: CAD file, 2022-08-14]
Mechanics/test/Reciever_seib.SLDPRT
20.5 x 1.50 x 10.4 mm
