42engineer42/Autonomous_drone_juuksur/Mechanics/test/reciever_KinnitusYlemine.SLDPRT

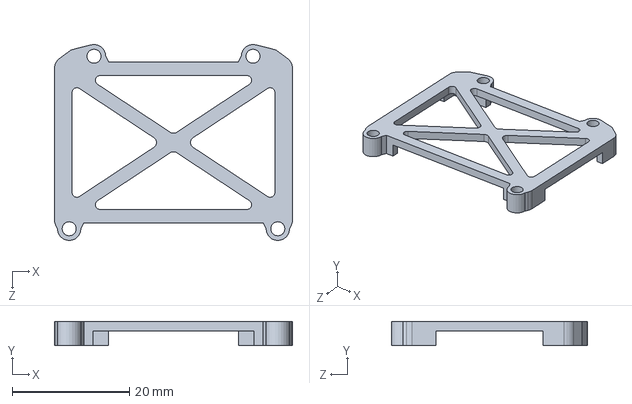
[picture p55: CAD file, 2022-08-14]
Mechanics/test/reciever_KinnitusYlemine.SLDPRT
40.6 x 4.10 x 33.4 mm
