42engineer42/Autonomous_drone_juuksur/Mechanics/test/jala_seib2.SLDPRT

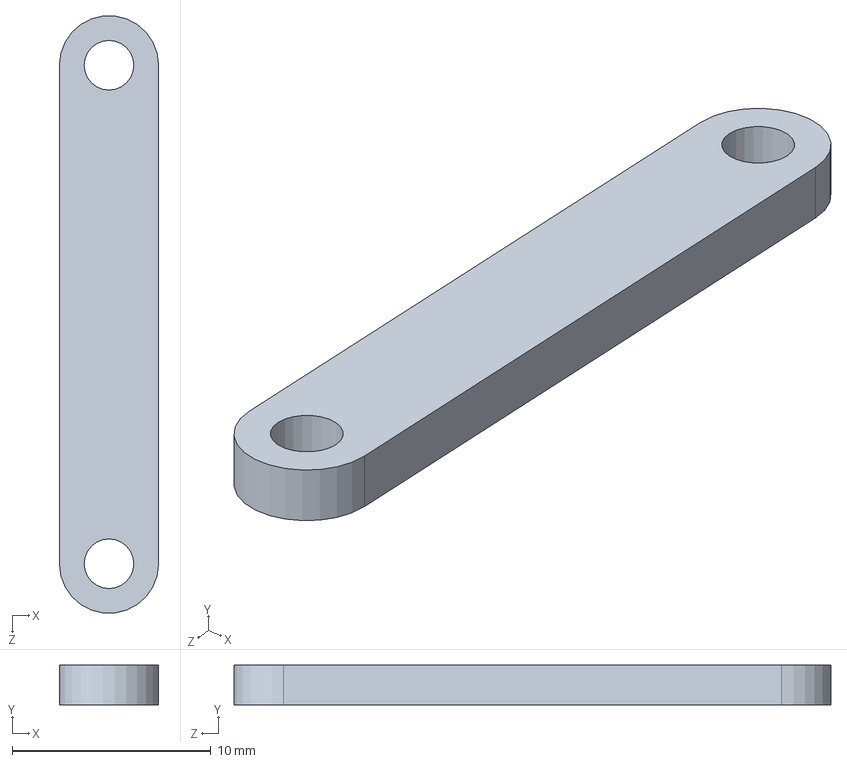
[picture p56: CAD file, 2022-08-14]
Mechanics/test/jala_seib2.SLDPRT
5.00 x 2.00 x 30.1 mm
