42engineer42/Autonomous_drone_juuksur/Mechanics/test/vaheplaat.SLDPRT

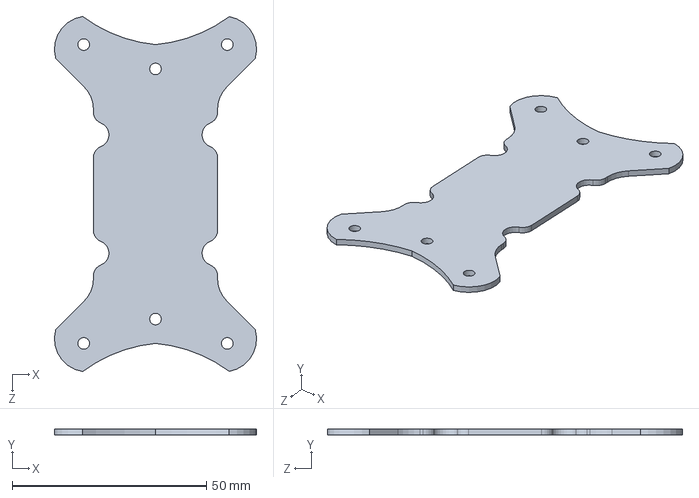
[picture p58: CAD file, 2022-08-14]
Mechanics/test/vaheplaat.SLDPRT
52.1 x 1.60 x 91.5 mm
