42engineer42/Autonomous_drone_juuksur/Mechanics/test/FUNDA 13.SLDPRT

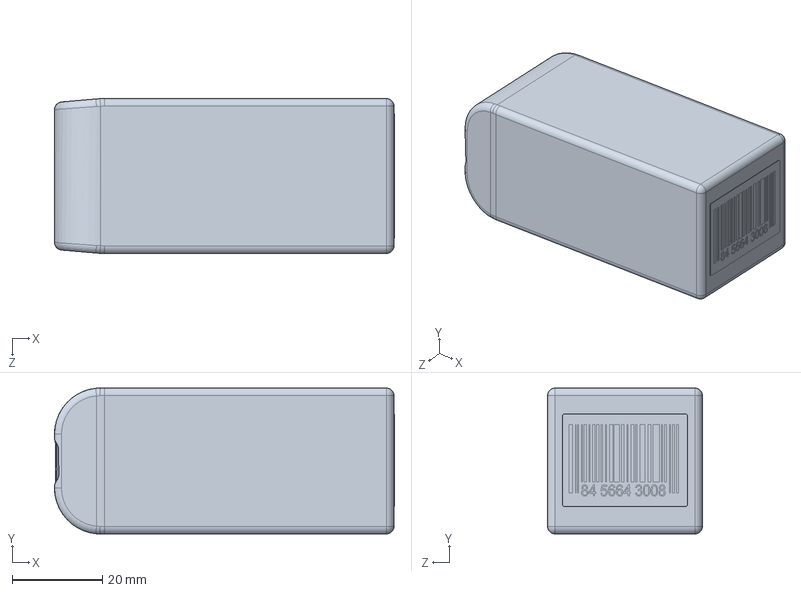
[picture p59: CAD file, 2022-08-14]
Mechanics/test/FUNDA 13.SLDPRT
75.5 x 32.4 x 34.4 mm
