42engineer42/Autonomous_drone_juuksur/(list of files, cad)

Other CAD files:
Mechanics/test/Kaablite hoidiku test.SLDASM
Mechanics/test/aku_vahesein.SLDPRT
Mechanics/test/vahepuks.SLDPRT
Mechanics/test/Kaabite hoidik.SLDPRT
Mechanics/test/Spacer.SLDPRT
Mechanics/REV3/Poola voistlus 2020 V1/Smarterdrone redesign/Aku kinnitus 1.SLDPRT
Mechanics/REV3/Poola voistlus 2020 V1/Smarterdrone redesign/Drone_arm.SLDPRT
Mechanics/REV3/Poola voistlus 2020 V1/Smarterdrone redesign/Droon_custom_PCB.SLDPRT
Mechanics/REV3/Poola voistlus 2020 V1/Smarterdrone redesign/Drooni jalg V6.SLDPRT
Mechanics/REV3/Poola voistlus 2020 V1/Smarterdrone redesign/Drooni jalg V7.SLDPRT
Mechanics/REV3/Poola voistlus 2020 V1/Smarterdrone redesign/Drooni riputi.SLDPRT
Mechanics/REV3/Poola voistlus 2020 V1/Smarterdrone redesign/Flexi seib.SLDPRT
Mechanics/REV3/Poola voistlus 2020 V1/Smarterdrone redesign/Jala kinnitus V3.SLDPRT
Mechanics/REV3/Poola voistlus 2020 V1/Smarterdrone redesign/Jala kinnitus_v2.SLDPRT
Mechanics/REV3/Poola voistlus 2020 V1/Smarterdrone redesign/Kaamera Lidari kinnitus.SLDPRT
Mechanics/REV3/Poola voistlus 2020 V1/Smarterdrone redesign/Kaamera cover.SLDPRT
Mechanics/REV3/Poola voistlus 2020 V1/Smarterdrone redesign/Lidari kaitse.SLDPRT
Mechanics/REV3/Poola voistlus 2020 V1/Smarterdrone redesign/Mutter.SLDPRT
Mechanics/REV3/Poola voistlus 2020 V1/Smarterdrone redesign/Pisem kaamera nurk.SLDPRT
Mechanics/REV3/Poola voistlus 2020 V1/Smarterdrone redesign/Post.SLDPRT
Mechanics/REV3/Poola voistlus 2020 V1/Smarterdrone redesign/Propeller CCW.SLDPRT
Mechanics/REV3/Poola voistlus 2020 V1/Smarterdrone redesign/Propeller CW.SLDPRT
Mechanics/REV3/Poola voistlus 2020 V1/Smarterdrone redesign/Puks_suur.SLDPRT
Mechanics/REV3/Poola voistlus 2020 V1/Smarterdrone redesign/Puks_vaike.SLDPRT
Mechanics/REV3/Poola voistlus 2020 V1/Smarterdrone redesign/Raspberry kinnitus v1.1.SLDPRT
Mechanics/REV3/Poola voistlus 2020 V1/Smarterdrone redesign/Raspberry pi CAMERA V2.SLDASM
Mechanics/REV3/Poola voistlus 2020 V1/Smarterdrone redesign/Reciever_assembly.SLDASM
Mechanics/REV3/Poola voistlus 2020 V1/Smarterdrone redesign/Reciever_seib.SLDPRT
Mechanics/REV3/Poola voistlus 2020 V1/Smarterdrone redesign/TATTU 1300mah 4s/Nueva carpeta/FUNDA 13.SLDPRT
Mechanics/REV3/Poola voistlus 2020 V1/Smarterdrone redesign/TATTU 1300mah 4s/Nueva carpeta/JST XHP-4.sldprt
Mechanics/REV3/Poola voistlus 2020 V1/Smarterdrone redesign/TATTU 1300mah 4s/Nueva carpeta/NUCLEO 13.SLDPRT
Mechanics/REV3/Poola voistlus 2020 V1/Smarterdrone redesign/TATTU 1300mah 4s/Nueva carpeta/XT60 Buchse.SLDPRT
Mechanics/REV3/Poola voistlus 2020 V1/Smarterdrone redesign/TATTU 1300mah 4s/TATTU 1300mah 4s.SLDASM
Mechanics/REV3/Poola voistlus 2020 V1/Smarterdrone redesign/TFmini lidar sensor CAD.SLDPRT
Mechanics/REV3/Poola voistlus 2020 V1/Smarterdrone redesign/Uued jupid/Aku kinnitus 1.STL
Mechanics/REV3/Poola voistlus 2020 V1/Smarterdrone redesign/Uued jupid/Aku kinnitusplaat.SLDPRT
Mechanics/REV3/Poola voistlus 2020 V1/Smarterdrone redesign/Uued jupid/Aku kinnitusplaat.STL
Mechanics/REV3/Poola voistlus 2020 V1/Smarterdrone redesign/Uued jupid/Kaamera cover.STL
Mechanics/REV3/Poola voistlus 2020 V1/Smarterdrone redesign/Uued jupid/Kaamera, aku ja lidari kinnitus V1.STL
Mechanics/REV3/Poola voistlus 2020 V1/Smarterdrone redesign/Uued jupid/Kaamera, aku ja lidari kinnitus.SLDPRT
Mechanics/REV3/Poola voistlus 2020 V1/Smarterdrone redesign/XT60 MALE.SLDPRT
Mechanics/REV3/Poola voistlus 2020 V1/Smarterdrone redesign/akuplaat.SLDPRT
Mechanics/REV3/Poola voistlus 2020 V1/Smarterdrone redesign/flight controller.SLDPRT
Mechanics/REV3/Poola voistlus 2020 V1/Smarterdrone redesign/jala assembly.SLDASM
Mechanics/REV3/Poola voistlus 2020 V1/Smarterdrone redesign/jala_seib1.SLDPRT
Mechanics/REV3/Poola voistlus 2020 V1/Smarterdrone redesign/jala_seib2.SLDPRT
Mechanics/REV3/Poola voistlus 2020 V1/Smarterdrone redesign/mootor.SLDPRT
Mechanics/REV3/Poola voistlus 2020 V1/Smarterdrone redesign/rasberry kate.SLDPRT
Mechanics/REV3/Poola voistlus 2020 V1/Smarterdrone redesign/reciever.SLDPRT
Mechanics/REV3/Poola voistlus 2020 V1/Smarterdrone redesign/reciever_KinnitusAlumine.SLDPRT
Mechanics/REV3/Poola voistlus 2020 V1/Smarterdrone redesign/reciever_KinnitusYlemine.SLDPRT
Mechanics/REV3/Poola voistlus 2020 V1/Smarterdrone redesign/vaheplaat.SLDPRT
Mechanics/REV3/Poola voistlus 2020 V1/Smarterdrone redesign/vaheplaat2.SLDPRT
Mechanics/REV3/Poola voistlus 2020 V1/Smarterdrone redesign/vahepuks.SLDPRT
Mechanics/REV3/Poola voistlus 2020 V2/Smarterdrone redesign/Alumine elektroonika.SLDASM
Mechanics/REV3/Poola voistlus 2020 V2/Smarterdrone redesign/Drooni jalg V6.SLDPRT
Mechanics/REV3/Poola voistlus 2020 V2/Smarterdrone redesign/Drooni riputi.SLDPRT
Mechanics/REV3/Poola voistlus 2020 V2/Smarterdrone redesign/Jala kinnitus V3.SLDPRT
Mechanics/REV3/Poola voistlus 2020 V2/Smarterdrone redesign/Jala kinnitus_v2.SLDPRT
Mechanics/REV3/Poola voistlus 2020 V2/Smarterdrone redesign/Kaamera Lidari kinnitus.SLDPRT
Mechanics/REV3/Poola voistlus 2020 V2/Smarterdrone redesign/Reciever_assembly.SLDASM
Mechanics/REV3/Poola voistlus 2020 V2/Smarterdrone redesign/TATTU 1300mah 4s/Nueva carpeta/FUNDA 13.SLDPRT
Mechanics/REV3/Poola voistlus 2020 V2/Smarterdrone redesign/TATTU 1300mah 4s/Nueva carpeta/JST XHP-4.sldprt
Mechanics/REV3/Poola voistlus 2020 V2/Smarterdrone redesign/TATTU 1300mah 4s/Nueva carpeta/NUCLEO 13.SLDPRT
Mechanics/REV3/Poola voistlus 2020 V2/Smarterdrone redesign/TATTU 1300mah 4s/Nueva carpeta/XT60 Buchse.SLDPRT
Mechanics/REV3/Poola voistlus 2020 V2/Smarterdrone redesign/TATTU 1300mah 4s/TATTU 1300mah 4s.SLDASM
Mechanics/REV3/Poola voistlus 2020 V2/Smarterdrone redesign/TFmini lidar sensor CAD.SLDPRT
Mechanics/REV3/Poola voistlus 2020 V2/Smarterdrone redesign/Uued jupid/Aku kinnitus 1.SLDPRT
Mechanics/REV3/Poola voistlus 2020 V2/Smarterdrone redesign/Uued jupid/Aku kinnitus 1.STL
Mechanics/REV3/Poola voistlus 2020 V2/Smarterdrone redesign/Uued jupid/Aku kinnitusplaat.STL
Mechanics/REV3/Poola voistlus 2020 V2/Smarterdrone redesign/Uued jupid/Kaamera cover.STL
Mechanics/REV3/Poola voistlus 2020 V2/Smarterdrone redesign/Uued jupid/Kaamera, aku ja lidari kinnitus V1.STL
Mechanics/REV3/Poola voistlus 2020 V2/Smarterdrone redesign/Uued jupid/rasberry kate.SLDPRT
Mechanics/REV3/Poola voistlus 2020 V2/Smarterdrone redesign/XT60 MALE.SLDPRT
Mechanics/REV3/Poola voistlus 2020 V2/Smarterdrone redesign/akuplaat.SLDPRT
Mechanics/REV3/Poola voistlus 2020 V2/Smarterdrone redesign/jala assembly.SLDASM
Mechanics/REV3/Poola voistlus 2020 V2/Smarterdrone redesign/rasberry kate.SLDPRT
Mechanics/REV3/Poola voistlus 2020 V2/Smarterdrone redesign/vahepuks.SLDPRT
Mechanics/REV4/STL/Kaabite hoidik.STL
Mechanics/REV4/STL/Spacer.STL
Mechanics/test/3D_print/aku_kaas.STL
Mechanics/test/3D_print/akuplaat.v2.STL
Mechanics/test/3D_print/receiver_kinnitus.STL
Mechanics/test/3D_print/testimisaas.STL
Mechanics/test/akuplaat.SLDPRT
