42engineer42/Autonomous_drone_juuksur/(list of files, drawings)

Other design files:
Electronics/REV3/Droon_REV3.PrjPCB
Electronics/REV3/Droon_REV3.SchDoc
Electronics/REV3/FC_PiHat_REV1.PcbDoc
Electronics/REV3/Power 3V3.SchDoc
Electronics/REV3/Power 5V.SchDoc
