42engineer42/Autonomous_drone_juuksur/Software/juuksur-master/JuuksurStm32/Inc/main.h

#define ARM_CH      4
#define AUTO_MODE_CH 5
#define CALIB_MODE_CH 6
#define LANDING_MODE_CH 7
#define TestLED2_Red_Pin GPIO_PIN_1
#define TestLED2_Red_GPIO_Port GPIOC
#define TestLED2_Green_Pin GPIO_PIN_2
#define TestLED2_Green_GPIO_Port GPIOC
#define TestLED2_Blue_Pin GPIO_PIN_3
#define TestLED2_Blue_GPIO_Port GPIOC
#define TestLED3_Red_Pin GPIO_PIN_0
#define TestLED3_Red_GPIO_Port GPIOB
#define TestLED3_Green_Pin GPIO_PIN_1
#define TestLED3_Green_GPIO_Port GPIOB
#define TestLED3_Blue_Pin GPIO_PIN_2
#define TestLED3_Blue_GPIO_Port GPIOB
#define TestLED4_Red_Pin GPIO_PIN_12
#define TestLED4_Red_GPIO_Port GPIOB
#define TestLED4_Green_Pin GPIO_PIN_13
#define TestLED4_Green_GPIO_Port GPIOB
#define TestLED4_Blue_Pin GPIO_PIN_14
#define TestLED4_Blue_GPIO_Port GPIOB
#define TestLED1_Red_Pin GPIO_PIN_7
#define TestLED1_Red_GPIO_Port GPIOC
#define TestLED1_Green_Pin GPIO_PIN_8
#define TestLED1_Green_GPIO_Port GPIOC
#define TestLED1_Blue_Pin GPIO_PIN_9
#define TestLED1_Blue_GPIO_Port GPIOC
#define TOF_Int_Pin GPIO_PIN_11
#define TOF_Int_GPIO_Port GPIOA
#define TOF_Int_EXTI_IRQn EXTI15_10_IRQn
