42engineer42/Autonomous_drone_juuksur/Software/juuksur2/src/raspi_telemetry/src/mock_encoder.c

#include "encoder.h"


int pushFrame(RPIEncoder *e, int w, int h, int stride, char *data) {
    return 1;
}

int initEncode(RPIEncoder *e, const char *fileName, const char *fn) {
    return 1;
}

void closeEncode(RPIEncoder *e) { 
}
