42engineer42/Autonomous_drone_juuksur/Software/juuksur-master/JuuksurStm32/Inc/tfmini_stm32.h

#pragma once

#include "tfmini.h"
#include "stm32f3xx_hal.h"

#define TFMINI_RBUF_SIZE (128)
#define TFMINI_RBUF_MASK (TFMINI_RBUF_SIZE-1)

typedef struct TfminiStm32State {
    TfminiState tfmini;
    volatile uint16_t rxReadPos;
    volatile uint16_t rxWritePos;
    uint8_t rxData;
    uint8_t ringBuf[TFMINI_RBUF_SIZE];
    UART_HandleTypeDef *huart;
} TfminiStm32State;

#ifdef __cplusplus
extern "C" {
#endif

void tfmini_stm32_init(TfminiStm32State *tfs, UART_HandleTypeDef *huart);
void tfmini_stm32_start_receive(TfminiStm32State *tfs);
void tfmini_stm32_receive_complete(TfminiStm32State *tfs);
void tfmini_stm32_process_rx(TfminiStm32State *tfs);

#ifdef __cplusplus
}
#endif
