42engineer42/Autonomous_drone_juuksur/Software/juuksur2.1/JuuksurStm32/Inc/tfmini.h

#pragma once

#include <stdint.h>

typedef struct TfminiState {
  uint8_t state;
  uint16_t dist; // in cm 30-1200 (65536 if over limit, 30 below)
  uint16_t strength;
  uint8_t reserved;
  uint8_t sigQ;
  uint8_t payload[6];
} TfminiState;

void tfmini_init(TfminiState *tm);
void tfmini_receive(TfminiState *tm, uint8_t data);
