42engineer42/Autonomous_drone_juuksur/Software/juuksur2.1/latest/juuksur/src/stm32_io/src/stm32_io_node.cpp

#include <ros/ros.h>
//#include <sensor_msgs/Image.h>
#include <std_msgs/UInt16.h>
#include <std_msgs/Float32.h>
#include <std_msgs/Bool.h>
#include <std_msgs/Int32.h>

#include <atomic>
#include <termios.h>
#include <fcntl.h>
#include <errno.h>
#include <cstdlib>
#include <linux/serial.h>
#include <sys/ioctl.h>
#include <pthread.h>
#include <math.h>

#include "tfmini.h"
#include "ibus.h"

// This code is ugly ang hacky but if it works, it works

// NOTE: these can be same
#if 0
// for tesing on PC
#define SERIAL_DEVICE_READ_FILE "/dev/pts/3"
#define SERIAL_DEVICE_WRITE_FILE "/dev/pts/2"
#else 
// for Pi
#define SERIAL_DEVICE_READ_FILE "/dev/serial0"
#define SERIAL_DEVICE_WRITE_FILE "/dev/serial0"
#endif

#define STMIO_FLAG_CTRL_YAW_VALID (1<<0)
#define STMIO_FLAG_CTRL_PITCH_VALID (1<<1)
#define STMIO_FLAG_CTRL_ROLL_VALID (1<<2)
#define STMIO_FLAG_CTRL_THROTTLE_VALID (1<<3)
#define STMIO_FLAG_CTRL_ARM_VALID (1<<4)

#define DEG2RAD 0.01745329251f

typedef struct Stm32IoState {
    uint32_t flags;
    std::atomic_bool senderRunning;
    ros::Publisher rangePub, yawPub, pitchPub, rollPub;
    ros::Publisher accXPub, accYPub, accZPub;
    ros::Publisher ctrlModePub;
    ros::Subscriber yawSub, pitchSub, rollSub, throttleSub, armSub;

    ros::Publisher sendPub;

    IbusState ibus;
    IbusChannels txChannels;
    IbusChannels lastRxChannels;
    uint8_t txBuf[32];
    uint8_t rxBuf[256];
    uint16_t ctrlYaw, ctrlPitch, ctrlRoll, ctrlThrottle, ctrlArm;
	int uartFd;
} Stm32IoState;

Stm32IoState stmio;

void ibus_event(void *usrData, IbusEvent *e);
void publish_data(Stm32IoState *stmio, IbusChannels *ch);
int getSerial(const char *fileName);

void ibus_event(void *usrData, IbusEvent *e) {
	switch(e->type) {
		case IBUS_CMD_CH:
			//ROS_DEBUG("ch %d %d %d %d\r\n", e->e.ch.channels[0], e->e.ch.channels[1], e->e.ch.channels[2], e->e.ch.channels[3]);
            publish_data((Stm32IoState*)usrData, &e->e.ch);
			break;
	}
}

void publish_data(Stm32IoState *stmio, IbusChannels *ch) {
    int16_t *yawRaw, *pitchRaw, *rollRaw;
    int16_t *accXRaw, *accYRaw, *accZRaw;
    std_msgs::Float32 range;
    std_msgs::Float32 yaw, pitch, roll;
    std_msgs::Float32 accX, accY, accZ;
    std_msgs::Int32 ctrlMode, landMode;
    stmio->lastRxChannels = *ch;

    yawRaw = (int16_t*)(ch->channels + 1);
    pitchRaw = (int16_t*)(ch->channels + 2);
    rollRaw = (int16_t*)(ch->channels + 3);
    accXRaw = (int16_t*)(ch->channels + 4);
    accYRaw = (int16_t*)(ch->channels + 5);
    accZRaw = (int16_t*)(ch->channels + 6);

    yaw.data = (float)(*yawRaw) / 100.0f;
    pitch.data = (float)(*pitchRaw) / 100.0f;
    roll.data = (float)(*rollRaw) / 100.0f;
    accX.data = (float)(*accXRaw) / 100.0f;
    accY.data = (float)(*accYRaw) / 100.0f;
    accZ.data = (float)(*accZRaw) / 100.0f;
    // ctrlmode - 0 is manual, 1 is autonomous, 2 is landing
    ctrlMode.data = ch->channels[7] < 1800 ? 0 : (ch->channels[8] < 1800 ? 1 : 2);

    range.data = (float)ch->channels[0] * cos(DEG2RAD * roll.data) * cos(DEG2RAD * pitch.data);
    if(range.data < 0.0f) { // extreme angle
	range.data = (float)ch->channels[0];
    }

    stmio->rangePub.publish(range);
    stmio->yawPub.publish(yaw);
    stmio->pitchPub.publish(pitch);
    stmio->rollPub.publish(roll);
    stmio->accXPub.publish(accX);
    stmio->accYPub.publish(accY);
    stmio->accZPub.publish(accZ);
    stmio->ctrlModePub.publish(ctrlMode);
    //ROS_INFO("dist %d cm acc %.2f \r\n", ch->channels[0], accZ.data);
    //ROS_INFO("raw dist %04dcm yaw %.2f(%04d) pitch %.2f(%04d) roll %.2f(%04d) acc (%.2f, %.2f, %.2f)\r\n", range.data, yaw.data, *yawRaw, pitch.data, *pitchRaw, roll.data, *rollRaw, accX.data, accY.data, accZ.data);
}

// TODO: can this be done with 1 callback?
void yawCb(const std_msgs::UInt16 msg) {
	stmio.ctrlYaw = msg.data;
    stmio.flags |= STMIO_FLAG_CTRL_YAW_VALID;
}
void pitchCb(const std_msgs::UInt16 msg) {
	stmio.ctrlPitch = msg.data;
    stmio.flags |= STMIO_FLAG_CTRL_PITCH_VALID;
}
void rollCb(const std_msgs::UInt16 msg) {
	stmio.ctrlRoll = msg.data;
    stmio.flags |= STMIO_FLAG_CTRL_ROLL_VALID;
}
void throttleCb(const std_msgs::UInt16 msg) {
	stmio.ctrlThrottle = msg.data;
    stmio.flags |= STMIO_FLAG_CTRL_THROTTLE_VALID;
}
void armCb(const std_msgs::UInt16 msg) {
	stmio.ctrlArm = msg.data;
    stmio.flags |= STMIO_FLAG_CTRL_ARM_VALID;
}

void *senderThreadProc(void *usrData) {
    int fd = getSerial(SERIAL_DEVICE_WRITE_FILE);
    Stm32IoState *s = (Stm32IoState*)usrData;
    while(s->senderRunning) {
        int txCount;
        // NOTE: even if reader thread writes stmio.ctrlRoll etc at same time it shouldn't matter
        // NOTE: 0 - roll, 1 - pitch, 2 - throttle, 3 - yaw
        // NOTE: sends 1500 if subscriber hasn't got any data (1000 for throttle)
        s->txChannels.channels[0] = (stmio.flags & STMIO_FLAG_CTRL_ROLL_VALID) ? stmio.ctrlRoll : IBUS_CHANNEL_DEFAULT;
        s->txChannels.channels[1] = (stmio.flags & STMIO_FLAG_CTRL_PITCH_VALID) ? stmio.ctrlPitch : IBUS_CHANNEL_DEFAULT;
        s->txChannels.channels[2] = (stmio.flags & STMIO_FLAG_CTRL_THROTTLE_VALID) ? stmio.ctrlThrottle : 1000;
        s->txChannels.channels[3] = (stmio.flags & STMIO_FLAG_CTRL_YAW_VALID) ? stmio.ctrlYaw : IBUS_CHANNEL_DEFAULT;
        s->txChannels.channels[4] = (stmio.flags & STMIO_FLAG_CTRL_ARM_VALID) ? stmio.ctrlArm : IBUS_CHANNEL_DEFAULT;
        s->txChannels.channels[7] = stmio.lastRxChannels.channels[8];
        int mres = ibus_make_packet(&s->txChannels, s->txBuf, sizeof(s->txBuf));
        if(mres >= 0) {
            txCount = write(fd, s->txBuf, sizeof(s->txBuf));
	    std_msgs::Int32 sendmsg;
	    sendmsg.data = 1;
	    s->sendPub.publish(sendmsg);
            // TODO: on partial write this isn't correct, but should not be fatal (if we use nonblocking fd)
            if(txCount < sizeof(s->txBuf)) {
                ROS_ERROR("Send fail: %s\r\n", strerror(errno));
            }
            //ROS_DEBUG("send %d\r\n", txCount);
        } else {
            ROS_ERROR("Failed to create packet, buffer too small??\r\n");
        }
        usleep(7000); // in microseconds!, nominally 142hz (7ms)
    }
    close(fd);
    return NULL;
}

int getSerial(const char *fileName) {
    int fd = -1;
	fd = open(fileName, O_RDWR | O_NOCTTY);
	if(fd < 0) {
        ROS_FATAL_STREAM("Failed to open "<< fileName << " - " << strerror(errno) << std::endl);
        ros::shutdown();
	}
	struct serial_struct serial;
	ioctl(fd, TIOCGSERIAL, &serial);
	serial.flags |= ASYNC_LOW_LATENCY;
	ioctl(fd, TIOCSSERIAL, &serial);
	struct termios serialOpt;
	tcgetattr(fd, &serialOpt);
	serialOpt.c_cflag = B115200 | CS8 | CLOCAL | CREAD;
	serialOpt.c_iflag = IGNPAR; // ignore characters with parity errors
	serialOpt.c_oflag = 0;
	serialOpt.c_lflag = 0;
    // VTIME=0 VMIN=0 is basically nonblocking mode (for reads, write() should be unaffected)
	serialOpt.c_cc[VTIME] = 0; // burst timer (tenths of second)
	serialOpt.c_cc[VMIN] = 1; // min number of ch to wait
	tcflush(fd, TCIFLUSH);
	tcsetattr(fd, TCSANOW, &serialOpt);
    return fd;
}

int main(int argc, char **argv)
{
	ibus_init(&stmio.ibus);
	ibus_set_event_callback(&stmio.ibus, ibus_event, &stmio);

	for(int i = 0; i < 14; i++) {
		stmio.txChannels.channels[i] = 1501;
	}
    ROS_INFO("Starting stm32_io node...\r\n");

    stmio.uartFd = getSerial(SERIAL_DEVICE_READ_FILE);
    stmio.flags = 0;
	
    ros::init(argc, argv, "example_node");
    ros::NodeHandle n("~");
    ros::Rate loop_rate(200); // data is sent by stm32 at approx 142Hz
	
    // publis range, yaw, pitch, roll
    stmio.rangePub = n.advertise<std_msgs::Float32>("/telemetry/range", 1, true); // 1 - queue size
    // these are actual angles reported by FC telemetry, not stick controls
    stmio.yawPub = n.advertise<std_msgs::Float32>("/telemetry/yaw", 1, true);
    stmio.pitchPub = n.advertise<std_msgs::Float32>("/telemetry/pitch", 1, true);
    stmio.rollPub = n.advertise<std_msgs::Float32>("/telemetry/roll", 1, true);
    stmio.accXPub = n.advertise<std_msgs::Float32>("/telemetry/accX", 1, true);
    stmio.accYPub = n.advertise<std_msgs::Float32>("/telemetry/accY", 1, true);
    stmio.accZPub = n.advertise<std_msgs::Float32>("/telemetry/accZ", 1, true);
    stmio.ctrlModePub = n.advertise<std_msgs::Int32>("/telemetry/controlmode", 1, true);
    // for debugging sending
    stmio.sendPub = n.advertise<std_msgs::Int32>("/telemetry/sendevent", 1);

    stmio.yawSub = n.subscribe<std_msgs::UInt16>("/control/yaw", 1, yawCb);
    stmio.pitchSub = n.subscribe<std_msgs::UInt16>("/control/pitch", 1, pitchCb);
    stmio.rollSub = n.subscribe<std_msgs::UInt16>("/control/roll", 1, rollCb);
    stmio.throttleSub = n.subscribe<std_msgs::UInt16>("/control/throttle", 1, throttleCb);
    stmio.armSub = n.subscribe<std_msgs::UInt16>("/control/arm", 1, armCb);

    pthread_t senderThread;
    stmio.senderRunning = true;
    if(pthread_create(&senderThread, NULL, senderThreadProc, &stmio)) {
        ROS_FATAL("Failed to create sender thread!\r\n");
        ros::shutdown();
    }

    // NOTE: this thread only reads and publishes, writing back to stm32 is done by a different thread
    // this should reduce latency on both sending and receiving (since OS can do scheduling better than us)
    while (ros::ok())
    {
        ros::spinOnce();
		// NOTE: checksum mismatch loop
		int rxCount = read(stmio.uartFd, (void*)stmio.rxBuf, 255);
		if(rxCount > 0) {
            //std::cout << "read() success " << errno << std::endl;
			//ROS_DEBUG("R %d\r\n", rxCount);
			for(int i = 0; i < rxCount; i++) {
				ibus_receive(&stmio.ibus, stmio.rxBuf[i]);
			}
		}
        else if(rxCount <= 0 && errno == EAGAIN) { // nothing received (must be nonblocking mode)
			//ROS_DEBUG("EAGAIN\r\n");
			//ROS_DEBUG("rx 0\r\n");
        }
        else if(errno != EINTR){ // EINTR occurs on exit, we don't care about it
            ROS_ERROR_STREAM("read() on serial port failed! " << errno << " " << rxCount << std::endl);
		} 
        //loop_rate.sleep();
    }

	close(stmio.uartFd);
	stmio.uartFd = -1;

    stmio.senderRunning = false;
    pthread_join(senderThread, NULL); // wait sender to exit
}
