42engineer42/Autonomous_drone_juuksur/Software/juuksur2.1/latest/juuksur/src/hover/src/HeightController.cpp

#include "HeightController.hpp"

HeightController::HeightController() {
}

void HeightController::heightUpdate(float newheight, double timestamp) {
}

void HeightController::accelerationUpdate(float newacc, double timestamp) {
}
