42engineer42/Autonomous_drone_juuksur/(commit log)

2022-06-14 Talise ja Timo kirjutatud koodi viimane versioon
    Talise ja Timo kirjutatud koodi viimane versioon, mis lennutab 2019 aasta robotexi reeglite järgi 8-kujulisel rajal robotit täiesti autononoomselt keskmise kiirusega umbes 12 s/ring (2m/s)
    [CompressedPublisher.cfg, CompressedSubscriber.cfg]
2022-08-14 Created Software directory and moved code files into it
    [CompressedPublisher.cfg, CompressedSubscriber.cfg]
2022-08-14 Added some electronics and mechanics files
    [Aku kinnitus 1.SLDPRT, Aku kinnitus 1.STL, Aku kinnitusplaat.SLDPRT, Aku kinnitusplaat.STL, Alumine elektroonika.SLDASM, Drone_arm.SLDPRT, Droon_REV3.PrjPCB, Droon_REV3.SchDoc]
2022-09-01 Code from Timo
    [test_calibration.yaml]
2022-09-03 Mechanics files
    [aku_kaas.SLDPRT, aku_vahesein.SLDPRT, akuplaat.v2.SLDPRT, juhtme_guide.SLDPRT, receiver_kinnitus.SLDPRT, testimisaas.SLDPRT]
2022-09-08 Testing the RC and STM32 connection.
