42engineer42/Autonomous_drone_juuksur/(notices)

Notices in the files:
Software/juuksur-master/JuuksurStm32/Src/main.c:
COPYRIGHT(c) 2019 STMicroelectronics
Software/juuksur2.1/JuuksurStm32/Src/usart.c:
Copyright (c) 2022 STMicroelectronics.
All rights reserved.
This software is licensed under terms that can be found in the LICENSE file
